SITProjects/INF2004/testing/terrain/TEST_LOG.md

# Terrain — test log

**Subsystem:** terrain  ·  **Student ID:** <student ID>  ·  **Code:** `app_program/terrain/`

See `testing/README.md` for how to run tests and record results.

## Test cases

Define a test here before running it. Test IDs never change.

| ID | What is tested | Requirement / interface | Method | Steps / how | Expected result |
|---|---|---|---|---|---|
| TER-U01 | IMU set up over I2C0 and delivering samples at about 100 Hz | | auto | `terrain_test.c`, GY-511 on Grove 3 | `[TEST] TER-U01 PASS` |
| TER-U02 | calibration becomes VALID within 5 s of power-up | | auto | `terrain_test.c`; car still on level ground during power-up | `[TEST] TER-U02 PASS` |
| TER-U03 | tilted car is refused | | manual | 1. Flash normal image with the car on a slope. 2. Watch the console. | `terrain: calibration NOT_LEVEL` |
| TER-U04 | pitch and roll read about 0 at rest after calibration | | auto | `terrain_test.c`; car still on level ground during power-up | `[TEST] TER-U04 PASS` |
| TER-U05 | pitch and roll match known angles | | manual | 1. Set `TERRAIN_DEBUG_PRINT_MS` to 500 locally (never commit it), build and flash. 2. Let it calibrate on level ground. 3. Tilt nose up to 10°, 20° and 30°, then nose down, checking each angle with a phone level app. 4. Repeat with the right side up, then the left side up. 5. Note the printed `pitch` and `roll` at each angle. | Within ±2° of the phone at each angle; nose up and right side up are positive |
| TER-U06 | record the level reference (after every remount) | | auto (bench) | 1. Set `TERRAIN_TEST_BENCH` to 1 locally (never commit it), build `make TEST=1` and flash. 2. Put the car on a floor checked to be flat. 3. Keep it still when the countdown ends. 4. Paste the printed `#define TERRAIN_LEVEL_REF_*` lines into `terrain_config.h` and rebuild. | `[TEST] TER-U06 PASS` and three `#define` lines |
| TER-U07 | each car axis points the right way after mounting | | auto (bench) | Same build as TER-U06; runs straight after it. Follow the console: 1. car flat; 2. nose lifted about 30°; 3. right side lifted about 30°. Hold still after each countdown until the reading prints. | Three `[TEST] TER-U07 PASS` lines; a FAIL names the `TERRAIN_CAR_*_FROM/SIGN` setting to check |
| TER-U08 | movement during calibration is retried | | manual | 1. Flash the normal image. 2. Shake the car gently for the first 3 s after power-up, then put it down flat and still. | `terrain: calibration VALID` about 2.5 s after the car is still |
| TER-U11 | IMU fault raised when the sensor stops and cleared when it is back | | manual | 1. Flash the normal image with the IMU connected; wait for `terrain: calibration VALID`. 2. Unplug the IMU cable from Grove 3. 3. Plug it back in. | After step 2: `terrain: IMU fault raised` within about 0.1 s (10 failed reads); after step 3: `terrain: IMU fault cleared`. Calibration stays VALID |
| TER-U12 | hump state machine and event queue give the right events | | auto | `terrain_test.c`; made-up roll data, so it needs only the Pico (the IMU may be missing). A 4-sample lean spike, then one ramp: climb and stay, come part way down, flat; then 17 events into the 16-event queue | Two `[TEST] TER-U12 PASS` lines: ASCENDING (carrying the lean), DESCENDING, LEVEL and nothing else; the oldest event dropped and counted |
| TER-U13 | no hump and no events at rest | | auto | `terrain_test.c`, runs after TER-U04; car still on level ground during power-up | `[TEST] TER-U13 PASS` (hump state LEVEL, the queue gives NONE) |
| TER-U14 | hump state follows the lean (one wheel lifted) | | manual | 1. Set `TERRAIN_DEBUG_PRINT_MS` to 500 locally (never commit it), build and flash. 2. Let it calibrate flat. 3. Lift one side of the car (or tilt the board sideways) about 6° and hold 1 s. 4. Lower it about 3° and hold 1 s. 5. Put it flat and still for 1 s. 6. Repeat with the other side | The printed `hump` reads ASCENDING then TOP during step 3, DESCENDING after 4 and LEVEL after 5, the same for either side. Tilting the nose up or down alone changes nothing |
| TER-U15 | hump height from made-up one-wheel ramps | | auto | `terrain_test.c`; one wheel driven at 120 mm/s over made-up ramps (each side three times as long as the ramp is high, 20 mm flat top) through the real hump machine (0.15 s tilt) and height code (its own 0.05 s smoothing), roll from the lift across the 110.6 mm track, so it needs only the Pico (the IMU may be missing). Ramps 6, 11 and 20 mm high | `[TEST] TER-U15 PASS` (each within ± 2 mm) |
| TER-U16 | hump height from a real lift of one wheel | | manual | 1. Build and flash (`make TEST=1` or `make`; the `terrain: hump` lines print without the debug switch). 2. Car on a flat floor; let it calibrate (`calibration VALID`). 3. Lift one drive wheel onto a block of known height (11 mm) for 1 s, then back down and still for 1 s. 4. Repeat with the other wheel. 5. Repeat with a 5–6 mm and a 15–20 mm block if available | Each lift prints `hump ASCENDING`, `hump DESCENDING`, `hump LEVEL height N mm` with N = block height ± 2 mm (a 5–6 mm block may only just be found) |
| TER-U17 | no false humps on a flat line run | | manual | 1. Flash the normal image (`make`); car still and level at power-up, then on a flat line track with no ramp. 2. Let it follow the line for at least one lap, including starts, stops and curves | `terrain: calibration VALID` before line following starts; no `terrain: hump` lines and no `events dropped` line. Any hump line is a false event: note where (start, stop, curve) |
| TER-U18 | one-wheel ramps on the line | | manual | 1. Flash the normal image (`make`); car still and level at power-up. 2. Put a ramp of known height under the path of one wheel on the line track: 11 mm (course), plus 5–6 mm and 15–20 mm if available. 3. Three runs each, then the same with the ramp under the other wheel | Each run prints ASCENDING, DESCENDING, LEVEL once, with the LEVEL height = ramp height ± 2 mm |
| TER-U19 | collision state machine on made-up pushes and speeds | | auto | `terrain_test.c`; made-up traces through the real collision code with the `terrain_config.h` limits, so it needs only the Pico (the IMU may be missing). Traces: a 0.8 g push; a 1.5 g push while the speed stays 120 mm/s (a jolt); pushes on a ramp (ASCENDING, DESCENDING) and a check cut short by ASCENDING; a 1.5 g then 1.8 g push with the speed dropping to 40 mm/s; a 2.5 g push with no stop; a 1.5 g push with the speed unknown; three 2.5 g pushes, the second inside the 500 ms cooldown | `[TEST] TER-U19 PASS` three times: no events for the first three traces; one COLLISION carrying 1.8 g; one carrying 2.5 g and one carrying 1.5 g; two events for the three pushes |
| TER-U20 | collision from a real push on the bench | | manual | 1. Build and flash the normal image (`make`). 2. IMU loose or car lifted off the floor, so motion's speed is 0 or unknown (the push alone decides). 3. Let it calibrate (`calibration VALID`), then keep it still. 4. Flick the board or car sharply sideways, then nose-first (a short hard tap, not a slow tilt). 5. Press it straight down hard. 6. Tilt it slowly to about 30 degrees and back | Steps 4: one `terrain: COLLISION push N g` line per flick, N at least 1.0. Steps 5 and 6: no COLLISION line (vertical push, slow tilt). Note the N values |
| TER-U21 | collisions and ramps on the car | | manual | 1. Flash the normal image (`make`); car still and level at power-up. 2. Drive at line-following speed into a soft wall (box, foam) 5 times, square on, then 5 times at an angle. 3. Drive over the 11 mm ramp under one wheel 5 times. 4. Line-follow one lap with starts, stops and curves. 5. To tune: set `TERRAIN_COLLISION_LIMIT_DG` to its lowest, 5 (0.5 g), locally so most bumps print, and repeat 2 and 3; never commit the lowered value | Step 2: one COLLISION line per hit. Steps 3 and 4: no COLLISION line. Step 5: note the smallest wall-hit push and the largest ramp or driving push; the limit goes between them, the sure value above every ramp push |
| TER-U22 | turn rate and turning state machine on made-up wheel speeds and turn rates | IF-05 | auto | `terrain_test.c`; made-up data through the real turn-rate maths and turning machine with the `terrain_config.h` limits, so it needs only the Pico (the IMU and motors may be missing). Wheel speeds: right 160 / left 80 mm/s, a turn in place at ±87 mm/s either way, equal speeds, a track width of 0. Turn-rate trace: still; 90 °/s one sample too short; 15 °/s (below the on limit); 90 °/s; 15 °/s (between the limits); still; a −25 °/s right curve; 5 °/s. Then the turn fields next to made-up hump fields | `[TEST] TER-U22 PASS` three times: 41.4, +90.1, −90.1, 0 and 0 °/s (± 0.5); TURNING, STRAIGHT, TURNING, STRAIGHT and nothing else; hump fields untouched by the turn step and cleared without touching the turning state |
| TER-U23 | turning on the car | IF-05 | manual | 1. Set `TERRAIN_DEBUG_PRINT_MS` to 500 locally (never commit it), build `make` and flash; car still and level at power-up. 2. Car still: note `turn`. 3. Turn in place 90° left, then 90° right (motion turn command). 4. Line-follow one lap with straights and curves. 5. Run one obstacle detour. 6. Stop tMotion (or unplug the motors' battery so odometry stops) and wait 2 s | Step 2: `turn 0 deg/s STRAIGHT`, no TURNING line. Step 3: one `terrain: TURNING` then one `terrain: STRAIGHT` line per turn; `turn` about +90 (left) and −90 (right) ± 5 while turning. Step 4: no TURNING lines on straights (small steering corrections ignored); note which curves give TURNING. Step 5: one TURNING/STRAIGHT pair per turn of the detour. Step 6: `turn 0 deg/s`, then STRAIGHT. Note any line on a straight: it means `TERRAIN_TURN_ON_DPS` is too low |
| TER-U24 | speed state machine on made-up wheel speeds | IF-05 | auto | `terrain_test.c`; made-up wheel speeds through the real speed machine with the `terrain_config.h` limits, so it needs only the Pico (the IMU and motors may be missing). Trace in whole 100 ms checks: stopped; one check at 100 mm/s; stopped; 40, 60, 80, 100 mm/s; 120 mm/s for 5 checks; one check at 140; 120 for 4 checks; 100, 80, 60, 40; stopped for 4 checks | `[TEST] TER-U24 PASS`: ACCELERATING, CRUISING, DECELERATING, STATIONARY and nothing else (the blip and the noisy check give nothing); ends STATIONARY |
| TER-U25 | speed state on the car | IF-05 | manual | 1. Set `TERRAIN_DEBUG_PRINT_MS` to 500 locally (never commit it), build `make` and flash; car still and level at power-up. 2. Car still: note `speed`. 3. Start line following from a standstill; run a straight, then stop it. 4. Turn in place 90° (motion turn command). 5. Stop tMotion (or unplug the motors' battery so odometry stops) and wait 2 s | Step 2: `speed STATIONARY`, no speed line. Step 3: `terrain: speed ACCELERATING`, then `CRUISING` within about 0.5 s; on the straight no more speed lines; on stopping `DECELERATING` then `STATIONARY`. Step 4: the same four lines (wheels speed up, steady, slow down, stop). Step 5: `STATIONARY` within about 0.3 s. Lines while cruising mean `TERRAIN_SPEED_CHANGE_MM_S` is too low; a missed ACCELERATING means it is too high |
| TER-U26 | run summary on made-up events | | auto | `terrain_test.c`; made-up events straight into the summary, so it needs only the Pico (the IMU and motors may be missing). 1. A short run with every kind of event: humps of 11, 9 and 20 mm, one COLLISION, two TURNING. 2. Humps of 10 to 80 mm, a 9th of 300 mm, 7 more of 5 mm, then 130 COLLISION and 130 TURNING. 3. Reset a used summary; NULL arguments | `[TEST] TER-U26 PASS` three times. Step 1: humps 3, heights 11 9 20, highest 20, collisions 1, turns 2, other kinds ignored; message `43 11 02 0B 09 14 00 00 00 00 00`. Step 2: after the 9th, count 9 and highest 255 with no 9th slot; at the end counts 15, 15, 127 and highest still 255; message `FF FF 7F 0A 14 1E 28 32 3C 46 50`. Step 3: all-zero message after the reset; NULL refused, nothing written |
| TER-U27 | run summary on the car | | manual | 1. Flash the normal image (`make`); car still and level at power-up. 2. Drive over the 11 mm ramp under one wheel 3 times. 3. Turn in place 90° twice (motion turn command). 4. Drive into a soft wall (box, foam) once. 5. Save the console output | A `terrain: summary` line right after every `hump LEVEL`, `TURNING` and `COLLISION` line, and at no other time. On the last one: humps 3 with the three LEVEL heights in order, highest the largest of them, collisions 1, turns at least 2 (curves may add more). Its `msg` bytes decode back to the same numbers: bytes 0-2 low byte first, hump count bits 0-3, highest 4-11, collisions 12-15, turns 16-22; bytes 3-10 the heights |
| TER-U28 | compass hard-iron offset (calibration spin) | | manual | 1. Flash `make MQTT=1 IR_CALIBRATION=1` (motors stay off) and log the MQTT console. 2. Put the car flat on the floor it will run on, away from laptops and steel. 3. Once `terrain: compass x …` lines appear (4 a second), turn the car slowly counter-clockwise by hand, two full turns in about 20 s, keeping it flat. 4. Set `TERRAIN_MAG_OFFSET_X` and `_Y` in `terrain_config.h` to the last `centre` values | `heading` rises while the car turns left and passes 0–3599 once per turn; the X and Y `span`s are within 20 % of each other and stop growing after the first turn; no `no reading` lines |
| TER-U29 | compass set up and reading | | auto | `terrain_test.c` | `terrain: compass ready` at start-up; at least 25 readings in 500 ms |
| TER-U30 | compass heading, range and fault handling on a stubbed magnetometer | | auto (host) | `sh testing/terrain/host/run.sh` in the dev container | `0 failure(s)` (CMP01..CMP05 PASS): heading counter-clockwise from north in 0–3599, X/Y range, an overflowed axis or failed read is no reading, set-up retried after 1 s |
| TER-U31 | compass against the wheel heading on the car | IF-05 | manual | After TER-U28: flash `make MQTT=1`, follow a line with a straight and a curve, save the `LT … c=… m=…` lines | while following, `c` changes by the same amount as `h` (within 10°) over the straight and the curve; on a straight `c` stays within 5° (the motor currents do not swing it) |
| TER-U33 | the course's hump through the real hump and height code | `terrain_detect.c`, `terrain_height.c` | auto (host) | `sh testing/terrain/host/run.sh` | TH01..TH14 PASS |
| TER-U34 | lifted and overturned stop the motors | IF-11, `terrain_detect.c`, `obstacle.c` | auto (host and on-target) + manual (car) | Host: `sh testing/terrain/host/run.sh` (LF01 to LF11, on cuts of the 2026-11-11 captures in `lift_fixture.h`). On target: `make TEST=1`. Car: flash `make MQTT=1`; drive a full lap, hump and junctions included, untouched; then lift the moving car briskly three times and the stopped car twice, putting it down and pressing Start each time; then turn it on its side and upside down | Host: 43 s of floor driving gives nothing; all eight demo-style lifts and both overturns are found; a slow, gentle lift is not (the known limit); margins either side of 1.30. Car: no stop during the lap; each lift gives `terrain: LIFTED` and `obstacle: car lifted`, the motors stop within about 0.3 s and the dashboard shows the car stopped; Start runs it again; each overturn gives `terrain: OVERTURNED` |

*Method:* **auto** = `TEST_CHECK` in code, result printed on the console;
**auto (bench)** = `TEST_CHECK` in code that needs a person to move the car on
cue, built only with `TERRAIN_TEST_BENCH` set to 1;
**auto (host)** = a host program runs the production module with stubbed
hardware, no Pico needed;
**manual** = a person observes the result (LED, scope, meter, phone app…).

## Results

Add a new row for every run. Never edit or delete old rows.

| Date | Test ID | Commit | Tester | Result | Log / evidence | Notes |
|---|---|---|---|---|---|---|
| YYYY-MM-DD | TER-U01 | `abc1234` | | PASS / FAIL | `logs/YYYY-MM-DD_….txt` | |
| 2026-11-02 | TER-U06 | `4a4be96` | ann | PASS | `logs/2026-11-02_ter_u06_level_ref.txt` | Loose IMU taped flat on a levelled desk; new reference X -0.470, Y 0.743, Z 8.491 m/s^2. TER-U07 not done (IMU stayed taped) |
| 2026-11-02 | TER-U01 | `4a4be96` + new reference | ann | PASS | `logs/2026-11-02_ter_u01_u02_u04.txt` | Packed code, loose IMU |
| 2026-11-02 | TER-U02 | `4a4be96` + new reference | ann | PASS | `logs/2026-11-02_ter_u01_u02_u04.txt` | VALID about 2.6 s after boot |
| 2026-11-02 | TER-U04 | `4a4be96` + new reference | ann | PASS | `logs/2026-11-02_ter_u01_u02_u04.txt` | Pitch and roll within 1 degree |
| 2026-11-02 | TER-U11 | `4a4be96` + new reference | ann | PASS | `logs/2026-11-02_ter_u11_imu_fault.txt` | Raised on unplug, cleared on replug, calibration stayed VALID. Sampling after the reconnect not checked |
| 2026-11-03 | TER-U12 | `d8f21d3` + P4 (uncommitted) | ann | PASS | `logs/2026-11-03_ter_p4_hump_events.txt` | Both checks: hump trace events and drop-oldest queue |
| 2026-11-03 | TER-U13 | `d8f21d3` + P4 (uncommitted) | ann | PASS | `logs/2026-11-03_ter_p4_hump_events.txt` | Loose IMU taped flat; hump LEVEL, queue empty |
| 2026-11-03 | TER-U02 | `d8f21d3` + P4 (uncommitted) | ann | PASS | `logs/2026-11-03_ter_p4_hump_events.txt` | VALID about 2.8 s after boot |
| 2026-11-03 | TER-U04 | `d8f21d3` + P4 (uncommitted) | ann | PASS | `logs/2026-11-03_ter_p4_hump_events.txt` | |
| 2026-11-03 | TER-U01 | `d8f21d3` + P4 (uncommitted) | ann | FAIL | `logs/2026-11-03_ter_p4_hump_events.txt` | Test-order artefact: other subsystems' tests skipped locally, so it ran before the IMU was set up. Not a P4 fault |
| 2026-11-03 | TER-U14 | `d8f21d3` + P4 (uncommitted) | ann | PASS | `logs/2026-11-03_ter_u14_hump_states.txt` | Loose IMU tilted by hand to about +45 deg and -30 deg: LEVEL, ASCENDING, TOP, DESCENDING, LEVEL. Wobbles under 4 deg ignored |
| 2026-11-03 | TER-U15 | `5973939` + P9 (uncommitted) | ann | PASS | `logs/2026-11-03_ter_p9_hump_height.txt` | First run, old reference: TER-U01, U12 x2, U15 PASS; TER-U02, U04, U13 FAIL (`calibration NOT_LEVEL`: IMU placed more than 2 deg from the 2026-11-02 reference). No log kept |
| 2026-11-03 | TER-U06 | `5973939` + P9 (uncommitted) | ann | PASS | values copied from the console (no log kept) | New bench reference X -0.366, Y 0.922, Z 8.522 m/s^2 (1.4 deg from 2026-11-02). Loose IMU taped flat, chip up. TER-U07 not done: the countdown could not be followed among other subsystems' console output |
| 2026-11-03 | TER-U01 | `5973939` + P9 (uncommitted) | ann | FAIL | no log kept | Run after TER-U06: TER-U12 x2 and U15 PASS; U01, U02, U04, U13 FAIL, no `terrain:` lines seen (likely the Grove cable, reseated before the next run, or the console opened late) |
| 2026-11-03 | TER-U01 | `5973939` + P9 (uncommitted) | ann | PASS | `logs/2026-11-03_ter_p9_hump_height.txt` | Cable reseated; new reference. Other subsystems' tests skipped locally in `app_main.c` (restored after) |
| 2026-11-03 | TER-U02 | `5973939` + P9 (uncommitted) | ann | PASS | `logs/2026-11-03_ter_p9_hump_height.txt` | |
| 2026-11-03 | TER-U04 | `5973939` + P9 (uncommitted) | ann | PASS | `logs/2026-11-03_ter_p9_hump_height.txt` | |
| 2026-11-03 | TER-U12 | `5973939` + P9 (uncommitted) | ann | PASS | `logs/2026-11-03_ter_p9_hump_height.txt` | Both checks: P4 unchanged by P9 |
| 2026-11-03 | TER-U15 | `5973939` + P9 (uncommitted) | ann | PASS | `logs/2026-11-03_ter_p9_hump_height.txt` | 40 mm narrow and 80 mm long-ramp made-up humps |
| 2026-11-03 | TER-U13 | `5973939` + P9 (uncommitted) | ann | PASS | `logs/2026-11-03_ter_p9_hump_height.txt` | |
| 2026-11-03 | TER-U16 | `5973939` + P9 (uncommitted) | ann | NOT RUN | — | Deferred to car day (bench set-up too fiddly; the debug print needed for it can freeze the console, Q3). Tilt estimate covered by TER-U15 and host tests |
| 2026-11-06 | TER-U28 | #136 | Kitsunez | PASS | `logs/2026-11-06_TER-U28_mqtt.txt` (not committed) | Two turns counter-clockwise by hand: heading rose through 0–3599 twice; spans X 956, Y 904 (6 % apart); centre X -347, Y -96, set as `TERRAIN_MAG_OFFSET_*`. Prints came every 0.6 s instead of 0.25 s: the terrain loop runs slow |
| 2026-11-06 | TER-U31 | #136 | Kitsunez | FAIL | `../system/logs/2026-11-06_car7_mqtt.txt` (not committed) | Line run, offsets applied offline. Field strength 210–315 counts while driving against 465 in the spin; `c` rose 25° over 150 mm of straight with `h` 0 and no sensor events; in turns `c` and `h` agree within about 15°. The motors (or the floor) disturb the compass: not usable for steering |
| 2026-11-07 | TER-U02 | level check widened for the mounted IMU | Kitsunez (host) | NOT RUN | `python3 testing/communication/host/dashboard_test.py` D26 | Not run on the car. All 53 calibrations logged on the car ended NOT_LEVEL against the 2026-11-03 bench reference, so tilt and humps never ran and CAR read 0. TERRAIN_LEVEL_MAX_DEG 2 to 30 for now; the `terrain: calibration` line now gives the tilt and reading to record as the new reference. Results land near 10.5 s: 0.5 s settling and five 2 s attempts, so samples arrive at 100 Hz and earlier attempts count as moved. |
| 2026-11-07 | TER-U02 | mounted level reference | Kitsunez (car and host) | PASS | `testing/system/logs/2026-11-06_dash5_mqtt.txt` boots 38 to 40 | Calibration VALID at 3.1 to 5.6 s with the 30 degree limit, 12.3 to 13.0 degrees from the old reference. New reference is the mean of the three; limit 5 degrees. First car run also counted 15 false humps, up to 48 mm: 15 of 17 starts were off the line. Humps now looked for only while following at 20 mm/s or more. One start at 2.7 degrees on a cross tape stays; no real hump run yet to set the threshold against. |
| 2026-11-07 | TER-U33 | real hump at 120 mm/s | Kitsunez (car and host) | PASS (host) | `testing/system/logs/2026-11-06_dash5_mqtt.txt` boot 42 | First real hump, inferred from roll: +2 to +4.4 degrees for about 2.3 s over d 1880 to 2160, counted, read 16 mm against 10. The car wobbled up to 15 degrees across it and stayed on the line. Five other detections lasted 0.2 to 0.6 s, in bends or just after the bypass. TERRAIN_HUMP_MIN_MS 800, so they no longer count; height smoothing 0.05 to 0.15 s, 9 to 10 mm in the model. The new height is not yet checked on the car. |
| 2026-11-07 | TER-U33 | humps by travel, collisions only driving | Kitsunez (car and host) | PASS (host) | `testing/system/logs/2026-11-06_dash5_mqtt.txt` boot 43 | One real hump, as the user confirmed: 188 mm from climb to level, 1.7 s, read 13 mm. Three false ones still counted over 0.8 s, at 34, 67 and 122 mm, so the rule is now 130 mm of travel. All 5 collisions false: 3 from starts, reversing or a slow pass restarting, one a hand on the stopped car, one at a 24 degree lean. Pushes now count only driving forward at 60 mm/s or more and leaning under 8 degrees. A real collision has not been tried. |
| 2026-11-07 | TER-U33 | hump survives braking for it | Kitsunez (car and host) | FAIL (car), PASS (host) | `testing/system/logs/2026-11-06_dash5_mqtt.txt` boot 48 | The user drove over the hump after `F` and none counted: `hu=0` all run. The slow-down braked the car under the 20 mm/s hump speed, which dropped the hump, so it sped up, leaned, braked again: 2 to 4 slow-downs a pass, most about 10 mm. Too slow now only pauses, and a car that slowed needs 90 mm of travel, not 130. In the closed-loop model the hump takes 119 mm and counts once, a steering lean 18 mm. Not yet run on the car. |
| 2026-11-09 | TER-U33 | slowed hump passes shorter than the minimum | Kitsunez (car and host) | FAIL (car, last image), PASS (host) | `testing/system/logs/2026-11-06_dash5_mqtt.txt` boots at 09:48 and 09:48:47, image 11:02:47 (not committed), `sh testing/terrain/host/run.sh` | Humps stayed 0. Five passes with the hump's roll of 5 to 7 degrees took 66 to 89 mm, under `TERRAIN_HUMP_SLOW_MIN_MM` 90. 15 logged slowed passes took 66 to 116 mm and leans with no hump 55 mm or under, so it is now 60; TH15 added. The three boots before those ended NOT_LEVEL (5.9 to 6.9 degrees), which turns humps off. Not run on the car. |
| 2026-11-09 | TER-U33 | level reference re-recorded | Kitsunez (car and host) | FAIL (car, last image), PASS (host) | `testing/system/logs/2026-11-06_dash5_mqtt.txt` boots from 09:39 to 10:51 (not committed), `sh testing/terrain/host/run.sh` | Seven of nine boots read NOT_LEVEL (5.1 to 9.4 degrees), and two passed at 4.3 and 4.9. The car rests about 5 degrees further front to back than when the reference was taken on 2026-11-07. New reference: the mean of eight of those boots, leaving out the 9.4. The nine boots then read 0.4 to 4.1 degrees. Whether that floor is flat was not checked. Not run on the car. |
| 2026-11-09 | TER-U33 (on the car) | slowed hump counted | Kitsunez | PASS | `testing/system/logs/2026-11-06_dash5_mqtt.txt` 11:23 boot, image 03:18:54 (not committed) | Three passes counted: 11, 7 and 9 mm, over 59, 89 and 110 mm of travel. No false hump from the other leans on those runs. |
| 2026-11-09 | TER-U21 | a hit counted from the wheels stopping dead | Kitsunez (car and host) | FAIL (car, last image), PASS (host) | `testing/system/logs/2026-11-06_dash5_mqtt.txt` 11:23 boot, image 03:18:54 (not committed), `sh testing/terrain/host/run.sh` | Three hits on a box from 120 mm/s, at d=180 to 194: the jolt read under 0.3, under 0.3 and 0.66 g, against 0.55 g just driving, 0.62 g braking and 0.95 g on the hump, so no push limit separates them. The speed fell to under 10 mm/s in under 0.5 s each time. TH16 to TH24 added, 11 mutations caught. In the logs, 4 such falls with no reason logged in about 5 hours of following. Not run on the car. |
| 2026-11-09 | TER-U21 (on the car) | a hit counted from the wheels stopping dead | Kitsunez | PASS (2 of 3) | `testing/system/logs/2026-11-06_dash5_mqtt.txt` 11:33 boot, image 03:30:15 (sonar limits 3/1/2 mm, not committed) | Two box hits counted, each once. The third was stopped by the ultrasonic's CRITICAL as the car touched the box, so it left following before the speed fell; the normal image stops well before that. No false count in those runs, but the log has no hump pass or long drive with this rule. |
| 2026-11-11 | TER-U34 (capture) | 100 Hz accelerometer with `TERRAIN_CAPTURE` 1, #148 | Kitsunez | INFO | `logs/2026-11-11_lift_capture_mqtt.txt`, `logs/2026-11-11_lift_capture2_mqtt.txt` (not committed) | The 100 ms mean's upward part, against the calibration's level reading: 43 s of floor driving with speed changes and bumps at most 1.17, never tilted over 20 degrees for more than 60 ms; eight demo-style lifts (five moving, three stopped) 1.42 to 1.63; a slow, gentle lift 1.09 and 22 degrees, the same as driving. On its side 73 to 110 degrees, upside down 147 to 179. The limits, 1.30 and 60 degrees for 300 ms, sit between. Collision detection is removed (TER-U19, TER-U21 retired). |
| 2026-11-11 | TER-U34 | #148 | Kitsunez (host) | PASS (host) | `sh testing/terrain/host/run.sh` | LF01 to LF11 pass; the full captures replayed through the firmware's code find every lift and overturn and nothing in the floor driving. 12 planted bugs each fail at least one check. On-target TER-U34 built (`make TEST=1`), not run. Not run on the car; the track's hump and junctions are not recorded at 100 Hz yet. |
