SITProjects/INF2004/testing/obstacle/TEST_LOG.md

# Obstacle — test log

**Subsystem:** obstacle  ·  **Student ID:** <student ID>  ·  **Code:** `app_program/obstacle/`

See `testing/README.md` for how to run tests and record results.

## Test cases

Define a test here before running it. Test IDs never change.

| ID | What is tested | Requirement / interface | Method | Steps / how | Expected result |
|---|---|---|---|---|---|
| OBS-U01 | scan task started (obstacle module initialised) and sleeps between scans | | auto | `obstacle_test.c` | `[TEST] OBS-U01 PASS` |
| OBS-U02 | servo PWM slice runs at 50 Hz (1 MHz counter, wrap 19999) | | auto | `obstacle_test.c` | `[TEST] OBS-U02 PASS` |
| OBS-U03 | clear path ahead reports CLEAR | | manual | 1. Flash normal image. 2. Keep at least 40 cm in front of the sensor clear (30 cm candidate threshold). 3. Watch the console. | `obstacle: [0x11] CLEAR dir 90` |
| OBS-U04 | obstacle inside the configured detection threshold starts a side scan | | manual | 1. Place a flat board at 150 mm (inside the configured detection distance and above critical release). 2. Watch the servo and console through both side positions and return to centre. | servo turns to 50° then 130°, then steps inward 10° from each end that missed the board; console reports `PATH_FOUND` or `BLOCKED`, with a width when measured, once after the sweep |
| OBS-U10 | packed obstacle fields at boundaries and invalid values | robot_types.h | auto | `obstacle_test.c`: valid flags, min/max/one-beyond/invalid fields, edge sentinels, width saturation and sequence wrap | `[TEST] OBS-U10 PASS`; neighbouring fields unchanged |

Additional regression cases:

| ID | What is tested | Requirement / interface | Method | Steps / how | Expected result |
|---|---|---|---|---|---|
| OBS-U12 | no-return and beyond-range policy | driver → scanner | manual | Scope TRIG/ECHO in open space; include a pulse lasting about 38 ms, if produced by this module. Record trigger-to-rise, pulse duration, driver outcome and scanner status. | NO_ECHO then CLEAR; late falling edge does not overwrite a result; next trigger waits for configured interval |
| OBS-U13 | malformed or stuck-high echo | driver → scanner | manual | Check ECHO high before trigger, duplicate/ambiguous edges and a zero pulse using controlled input. | FAULT; never classed as a no-return clear reading |
| OBS-U14 | side selection and fault policy | scanner | manual | With motors unable to move, keep the centre obstacle inside detection. Arrange one finite side return beyond both the configured detection threshold and the centre echo + `OBSTACLE_EDGE_JUMP_US` (about 80 mm additional ray range); repeat with the sides mirrored, both sides occupied, NO_ECHO and a faulty side. Record centre/side echoes and final direction. | Only a side meeting both limits, or NO_ECHO, is chosen; farther clear wins and ties choose left. No clear side gives BLOCKED, or UNKNOWN if a side faulted |
| OBS-U15 | active pin allocation | config → hardware | manual | Scope GP16 TRIG width and nominal forward trigger cadence in a stable clear-path centre scan (allow polling jitter; side scans have different cadence); scope GP12 servo period/centre width. Confirm GP17 input changes with sensor distance. Inspect GPIO function/output-enable registers or debugger pinmux state and obstacle source to establish ownership of GP2/GP3; quiet pins alone do not establish pin allocation. | TRIG GP16, ECHO GP17, servo GP12; one configured scan priority |
| OBS-U16 | ping median | `obstacle_decision.c` | auto | `obstacle_test.c`: zeros ignored (not majority voting: `{0, 0, 300}` gives 300 us), two nonzero samples averaged without overflow, all-zero gives 0, NULL/zero count gives 0, only the first 3 samples used | `[TEST] OBS-U16 PASS` |
| OBS-U17 | position result after its pings | `obstacle_decision.c` | auto | `obstacle_test.c`: exhausted retries give FAULT regardless of median; zero median gives NO_ECHO; otherwise VALID | `[TEST] OBS-U17 PASS` |
| OBS-U18 | centre decision at the detection threshold | `obstacle_decision.c` | auto | `obstacle_test.c`: NO_ECHO, echo at and above `OBSTACLE_DETECT_ECHO_US` → CLEAR; one below and 1 µs → scan sides; FAULT/PENDING → UNKNOWN | `[TEST] OBS-U18 PASS` |
| OBS-U19 | side selection | `obstacle_decision.c` | auto | `obstacle_test.c`: 22 cases covering both near, detection and flat-face (centre / cos 40° + jump at the 40°-off ends) boundaries, a square-on wall reading the centre echo / cos 40° at the ends, ties, farther side, no-echo ranking, faults, and 32-bit addition near UINT16_MAX | `[TEST] OBS-U19 PASS`; on failure the console names the failing case number |
| OBS-U52 | side/width classification agreement | `obstacle_decision.c`, `obstacle_width.c` | auto | Grid of centre/side echoes at detection and end flat-face boundaries, zero and UINT16_MAX; test both directions with the opposite side faulted | A VALID side is chosen exactly when it is a width MISS and meets detection; otherwise UNKNOWN with no direction; sums do not wrap |
| OBS-U54 | wide wall must not offer a bypass | scanner, #88 | manual | Motors unable to move; after ranging/servo calibration, place a flat board square-on at 250 mm, then 290 mm from the sensor face, spanning the entire 50–130 degree sweep. Capture five complete sweeps at each position, recording measured echoes and final results | Every completed valid sweep is BLOCKED, never PATH_FOUND; sensor faults are recorded separately and are not PASS |

Width sweep cases (#48). Synthetic geometry uses a fixed fixture (scale 1715,
no offsets, correction 0 unless stated), so production calibration cannot
change the expected values.

| ID | What is tested | Requirement / interface | Method | Steps / how | Expected result |
|---|---|---|---|---|---|
| OBS-U05 | sweep classification | `obstacle_width.c` | auto | Centre 1458 us: at the centre VALID 1923, 1924 and 1, NO_ECHO, FAULT, PENDING; 30° off (indices 1/7) VALID 2149 and 2150; 40° off (indices 0/8) VALID 2368 and 2369; beyond the grid VALID 1924; centre 65500 with VALID 65535 at the centre and an end | HIT, MISS, HIT, MISS, INVALID, INVALID; HIT, MISS; HIT, MISS; MISS (treated as centre); HIT, HIT (no wrap) |
| OBS-U06 | wall wider than the sweep | `obstacle_width.c` | auto | Wall 100 mm ahead: hits at indices 0 and 8 (50°/130°), 761 us each | 168 ±2 mm; both edges not found; edges 0/8 |
| OBS-U07 | centred box | `obstacle_width.c` | auto | 200 mm box at 250 mm: hits at indices 2 and 6 (70°/110°), 1551 us | 225 ±2 mm; both found; boundaries 65.0° and 115.0° |
| OBS-U08 | shifted box | `obstacle_width.c` | auto | Same box 80 mm left: hits 1 (60°, 1683 us) and 4 (1458 us); a 230 mm box 150 mm ahead: hits 1 and 7 (60°/120°), 1010 us | 188 ±2 mm, both found; 199 ±2 mm, both found (the 60–120° sweep found neither edge); no edge correction |
| OBS-U09 | pole and collapsed edges | `obstacle_width.c` | auto | 20 mm pole at 250 mm: both hits at 6, 1458 us; then correction 6° | 44 ±2 mm (half steps of 5°), not collapsed; then 1 mm, collapsed, both boundaries 90.0° |
| OBS-U11 | saturation and rejected input | `obstacle_width.c` | auto | Ends at 3499 us; left index 7, right index 5, index 13, zero echo, NULL config, scale 0, correction NaN/infinite/−1/16, radial offset −500 mm and infinite | 511 mm; every rejected case unavailable (0 mm, EDGE_NONE, flags false) |
| OBS-U33 | width accuracy and edge correction | scanner → obstacle word | manual | After OBS-U28/U29/U30 and the pivot measurement, with the car unable to move: fit the edge correction on centred 200 mm boxes at 200 and 250 mm (c = 0 build, boundary angles from the log), then run the validation matrix in the #48 plan, 5 runs per case. Measure d from the servo axis | Eligible cases (\|x0\| + W/2 < 0.577 d, 10 mm margin): both edges found and every run within 10 %; a missed edge is a FAIL. Clipped cases: clipped side not found, width ≤ visible width ±10 mm. Two-box case recorded as a limitation |
| OBS-U34 | sweep time | scanner | manual | 200 mm box at 250 mm, 10 runs: `side scan started` to `side scan completed after N ms` | Every run below `OBSTACLE_SIDE_SCAN_WORST_MS`; mean and max recorded. Does not show the whole-bypass < 3 s target (integration) |

Bypass geometry, planner and state machine (issue #86):

| ID | What is tested | Requirement / interface | Method | Steps / how | Expected result |
|---|---|---|---|---|---|
| OBS-U35 | bypass plan, left gap | `obstacle_avoid.c` | auto | Fixture car (W/2 75, margin 60, axle–pivot 80, rear 60, depth 200); centre 250 mm, edges ±100 mm | Sidestep 235 mm, pass 650 mm, status OK |
| OBS-U36 | bypass plan, clearest side | `obstacle_avoid.c` | auto | Edges +40 and −120 mm with the scanner choosing right; then only the right edge found | Measured-clearer right taken at 255 mm despite a 175 mm left detour; a scanner-selected left without a left edge stays left at the 400 mm maximum |
| OBS-U37 | bypass plan limits, best effort | `obstacle_avoid.c` | auto | Needed sidestep 401 and 400 mm; below the minimum; only the right edge; width unavailable; pass 1500 and 1501 mm; split counts and parts | 401 capped to 400 with `b_limited`; 400 kept; raised to 100; scanner-selected left without an edge gives 400; unknown width gives 400 on the scanner's side; 1501 capped to 1500 with `b_limited`; splits 0/1/1/2/2/3 for 0/1/1023/1024/2046/2047 mm, parts 750 for 1500 and 683 for 2047 |
| OBS-U38 | bypass plan refusals | `obstacle_avoid.c` | auto | SCANNING, CLEAR, UNKNOWN; BLOCKED with the right edge found; BLOCKED with no edge; PATH_FOUND centre with no edge; centre 0; NULL car | NOT_PATH, except BLOCKED with a found edge plans round it (right, 235 mm); NO_GEOMETRY for centre 0 |
| OBS-U39 | edge lateral offsets | `obstacle_width.c` | auto | OBS-U07 box (edges 65° and 115° at 266 mm); unavailable result | `left_x_mm` 109..115, `right_x_mm` −115..−109; unavailable gives 0, 0 |
| OBS-U40 | range reference point | `obstacle_width.c` | auto | 1551 µs at the fixture scale with a 20 mm radial offset; echo 0, NULL config or output, range at or below zero | 286 ±0.5 mm from the pivot (offset added once); every invalid case false with the output untouched |
| OBS-U41 | corridor check | `obstacle_avoid.c` | auto | Fixture car, pass 650 mm: empty sweep; 250 mm ahead; 290 mm at 100° (left gap) and 80° (right gap); 800 mm ahead plus a 400 mm wall at 60°; that wall with 250 mm ahead; one invalid position | CLEAR; SHIFT 135; SHIFT 85 both mirrors; CLEAR; BLOCKED (65 mm room < 135 mm); BLOCKED |
| OBS-U42 | bypass: start-up hold and stop | `obstacle_avoid.c` (simulated tMotion) | auto | Start held; 20 loops with the stop latched; clear path; stop while following; tMotion that never reports INHIBITED | No INHIBIT clear until the first clear result, then FOLLOW and IDLE; INHIBIT set in the loop that sees the stop; WAIT_RESULT on INHIBITED; FAULT `STOP_ACK` after 500 ms, not before |
| OBS-U43 | bypass: release order and pending commands | `obstacle_avoid.c` (simulated) | auto | PATH_FOUND with tMotion still INHIBITED for 3 loops; sends return E_TMOUT; FOLLOW busy for over 200 ms; send error; failed INHIBIT call | No send until INHIBITED is left; the same turn resent until queued, exactly once; FOLLOW also resent, FAULT `KERNEL` past 200 ms; send error and INHIBIT failure latch FAULT at once |
| OBS-U44 | bypass: latched stop across turns | `obstacle_avoid.c` (simulated) | auto | Stop still latched from detection; rearm publishes sequence 255; CLEAR at 255, then CLEAR at 0; a fresh UNKNOWN in PREPARE | The turn runs with the stop latched; the sidestep waits in PREPARE through the stale CLEAR and is sent at sequence 0 (wrap); UNKNOWN holds in BLOCKED_WAIT |
| OBS-U45 | bypass: verify and repeated sidesteps | `obstacle_avoid.c` (simulated) | auto | Two corridors with a point 250 mm ahead, then a clear one; stale corridor sequence; sidesteps limited to 1 | Extra 135 mm sidesteps each time; offset 505 mm; return command 655 mm with stop-at-line; stale sweep ignored; over the limit: BLOCKED_WAIT, FAULT `BLOCKED` after 5 s |
| OBS-U46 | bypass: return leg completion | `obstacle_avoid.c` (simulated) | auto | 900 mm sidestep (1050 mm return in two parts), line seen on the first part; line missed twice on a normal return | First part 525 mm; DONE_LINE skips the remaining return, drives the 40 mm overshoot, then turns 90° left back to the stop heading (odometry −90 → 0) and sends FOLLOW; first miss holds 1 s then searches 150 mm with stop-at-line; second miss hands over to line following (FOLLOW, no FAULT) |
| OBS-U47 | bypass: faults and the one retry | `obstacle_avoid.c` (simulated) | auto | Stall at 100 of 235 mm; second stall; 1000 loops of clear paths and new PATH_FOUND results in FAULT; stall at 230 mm; ENC_FAULT; REJECTED; stall without odometry | Resumes 135 mm after the delay; then FAULT; FAULT keeps asking for INHIBIT and never clears it, sends or rearms; 5 mm remainder counts as done (turn back next, offset 235 mm); FAULT `ENCODER`, `REJECTED`, `ODOMETRY` |
| OBS-U48 | bypass: obstacles during the bypass | `obstacle_avoid.c` (simulated) | auto | Stop at 50 mm into the sidestep, cleared; a stop that never clears; stop and then CRITICAL during the first turn; a full box with ideal answers | Held, then resumes 185 mm after a fresh CLEAR; FAULT `BLOCKED` after 5 s; turn ignores the stop but holds on CRITICAL; full box ends with FOLLOW queued and IDLE |
| OBS-U55 | bypass: angled path | `obstacle_avoid.c` (simulated) | auto | Fixture car with a 30° minimum: plan angles at centre 250, 600 and 50 mm; then a full bypass at 600 mm | Angles 55°, 30° and 90° (and 90° with a 90° minimum); commands in order: turn 30° left, 470 mm, turn 30° right, 593 mm pass (1000 less the diagonal's 407), turn 15° right without and 15° right with stop-at-line, 770 mm with stop-at-line; when that return finds a line, 40 mm on, turn 30° left back to the stop heading, FOLLOW |
| OBS-U56 | bypass without re-checks | `obstacle_avoid.c` (simulated) | auto | Re-checks off; the stop request latched through a whole box; then CRITICAL 50 mm into the sidestep, cleared with the stop still latched | No rearm or corridor request; the latched stop never holds a move; full box ends with FOLLOW; CRITICAL holds, and clearing it resumes 185 mm without a rearm |
| OBS-U57 | bypass back-off | `obstacle_avoid.c` (simulated) | auto | Re-checks off, 50 mm back-off, 2 at most, 300 ms delay: CRITICAL 100 mm into the 235 mm sidestep, three times | Planning turns side scans off; each hold reverses 50 mm then drives the remainder plus 50 mm (185, then 235 mm); the third turns back to re-sweep; the box completes and FOLLOW turns side scans back on |
| OBS-U58 | bypass re-sweep | `obstacle_avoid.c` (simulated) | auto | CRITICAL held on the pass (left side, 235 mm out), then a corridor with a point 250 mm ahead; CRITICAL held 100 mm into the sidestep, then a clear corridor | Pass: corridor re-sweep, then a 135 mm extra sidestep on the left (offset 235 mm so far), INHIBIT released, turn 90° left. Sidestep: turn back keeping 100 mm offset, corridor re-sweep, then the 650 mm pass |
| OBS-U59 | bypass reverse for room | `obstacle_avoid.c` (simulated) | auto | 200 mm minimum room: plans at 50 mm and 250 mm; a bypass starting 50 mm away with CRITICAL set, then a corridor with a point ahead; again with a clear corridor | 50 mm: reverse 150 mm, pass 600 mm; 250 mm: no reverse. The bypass reverses 150 mm first (CRITICAL does not stop a reverse), sweeps the corridor, then turns 90° left for a 135 mm sidestep. With a clear corridor it resumes FOLLOW |
| OBS-U60 | bypass plan, free space first | `obstacle_avoid.c` | auto | Edges +300 (left needs 435) and −40 mm (right needs 175), scanner chose right: left end clear only; both clear; right clear only with no right edge | Left only: left, capped at 400 with `b_limited`. Both: right at 175. Right only: right at 400, edge unknown |
| OBS-U61 | bypass back-off in a turn | `obstacle_avoid.c` (simulated) | auto | Re-checks off, one 50 mm back-off, 300 ms delay: CRITICAL 40° into the 90° turn out | Holds; after 300 ms reverses 50 mm; then turns the remaining 50° |
| OBS-U62 | bypass: no side fits, reverse and look again | `obstacle_avoid.c` (simulated) | auto | Re-checks off, start 50 mm away (reverse for room), corridor blocked both ways three times; again with a clear corridor after the first; then a BLOCKED first sweep | Each blocked corridor reverses 100 mm and sweeps again (escape 100, 200, 300 mm), then waits held in BLOCKED_WAIT; clear after the first: FOLLOW; BLOCKED first sweep: reverses 100 mm before any turn, then sweeps. No 90° look |
| OBS-U63 | bypass: complete pass before route reacquisition | `obstacle_avoid.c` (simulated) | auto | Both gap directions: outward move and pass ignore line crossings; the first half of the turn in has no stop-at-line; inject LINE on the second half of the turn in and on the return; delay the overshoot enqueue; combine LINE with CRITICAL and outward obstruction | No early line handoff before completing the pass or before half the turn in; LINE queues the 40 mm overshoot (busy retries), then a home turn of 45° (after half the turn in) or 90° (after the return) toward the gap side, then FOLLOW at the stop heading; obstacle inhibition retains priority |
| OBS-U64 | measured-clearance preference reaches the planner | scanner decision → planner | auto | Both mirrors: farther clear echo on the side needing a 435 mm detour versus 175 mm on the other; remove the preferred edge; then NO_ECHO versus a finite return | Preferred farther side is retained, capped at 400 if necessary; unknown edge does not flip it; NO_ECHO ranks above finite clearance |
| OBS-U65 | replan chooses the clearest usable sector | corridor → planner | auto | Central obstacle needing equal shifts: side returns 6000/9000 us, mirrored, equal, and right NO_ECHO | Greater nearest sector clearance wins; ties retain the current side; NO_ECHO outranks finite returns; feasibility and lateral limits still apply |
| OBS-U66 | bypass plan, room past a clear end | `obstacle_avoid.c` | auto | Fixture car, centre 250 mm, edges ±60 mm (195 mm sidestep either way), scanner chose right, both ends clear; ends 40° off the heading; right end at 513, 514 and 849 mm; then both ends at 300 mm; then left at 350 mm | 513 mm (329.8 mm out, needs 330): left at 195; 514 mm: right; 849 mm (650.4 mm ahead, beyond the 650 mm pass): right; both at 300 mm: the scanner's right, flagged tight (no reverse); left at 350 mm: the roomier left, flagged tight |
| OBS-U67 | bypass: watch the obstacle side while driving | `obstacle_avoid.c` (simulated) | auto | Left gap, 235 mm sidestep, re-checks off; watch readings on the diagonal of 220 mm (110 mm from the path) then 200 mm (100 mm); on the pass 100 mm in, 200 mm; in the extra sidestep, 40 mm; on the pass again, 200 mm; then no echo after 0, 223 and 224 mm more | Servo set to 60° (right on the car). 110 mm is outside the 105 mm trigger (half the car plus half the margin): no change. 100 mm: diagonal lengthened to 270 mm (35 mm, restoring the 135 mm margin), sent as a 35 mm part. On the pass: held, 35 mm extra sidestep (70 mm in all). The 40 mm and later 200 mm readings would pass the 80 mm cap: refused, the pass continues for 550 mm at 305 mm out. No echo while the last point seen (174 mm ahead) is not passed by 50 mm keeps watching; at 224 mm: servo back ahead, watch done |
| OBS-U69 | bypass: back to the stop heading | `obstacle_avoid.c` (simulated) | auto | Stopped on heading 0; line found on the return with odometry at −97°, −2°, +350° and with odometry invalid | Home turn 97° left (not the planned 90°); −2° is under the 3° resume minimum: FOLLOW at once; +350°: 10° left, the shorter way; no odometry: FOLLOW without a home turn, no FAULT |
| OBS-U70 | the echo is still timed correctly through the shared GPIO interrupt dispatcher (`drv_gpio_irq.c`) with the barcode pin attached | driver → scanner, TEAM.md section 3 | manual | 1. Flash `make TEST=1`: the OBS on-target echo tests and BAR-U02 must pass. 2. Flash `make MQTT=1`, place an obstacle at about 200 mm and slide a barcode card under the barcode sensor while the scan runs. | OBS tests PASS; the centre echo stays within its usual spread while barcode edges arrive, with no echo FAULT and no `barcode: edge queue overflow` |
| OBS-U72 | bypass plan: pass ends short of the rear bumper when the edge is known | `obstacle_avoid.c` | auto | `sh .handoff/tools/hosttest/host.sh` | Far face plus (half width + margin) x tan(angle / 2); an unknown edge keeps full rear clearance; a short tail never lengthens the pass |
| OBS-U73 | bypass: black far from the line is not the line | `obstacle_avoid.c` (simulated) | auto | `sh .handoff/tools/hosttest/host.sh`; `line_gate_mm` 100, both sides, then a gate wide enough to reach | Too far out, the turn in and the first part of the return do not look for the line; the last part does; near enough, the turn in looks again |
| OBS-U74 | width close up from the corners' range | `obstacle_width.c` | auto | `sh .handoff/tools/hosttest/host.sh`; logged echoes | A 16 cm scan reads under 190 mm where the grid gives over 200; never raised; off beyond 200 mm, with an edge short of 60 or 120 degrees, or with an edge not found |
| OBS-U75 | width: an end behind the flat face is not the obstacle | `obstacle_width.c`, `obstacle_scan.c` | auto | `sh .handoff/tools/hosttest/host.sh`; logged echoes | Ends 125 and 157 us behind the face, the other end clear, are not edges; ends in front of it are; 100 us is the limit; with no clear end an end always stands |
| OBS-U76 | bypass: the sidestep watches the obstacle's front | `obstacle_avoid.c` (simulated) | auto | `sh .handoff/tools/hosttest/host.sh` | Both sides: the sidestep's watch faces back along the line, the turn's angle round from ahead within 30..150 degrees; losing the face at its edge does not end the watch; the pass watches at 60 or 120 as before |
| OBS-U77 | bypass: a car stopped off the line's heading turns onto it and measures | `obstacle_avoid.c` (simulated) | auto | `sh .handoff/tools/hosttest/host.sh` | Stopped 8 degrees left of the heading averaged over the last 96 mm, 250 ms after the stop the car releases, turns 8 right, stops again and rearms the scanner; the bypass ends on the new heading; once per stop. Both ways. A stall or CRITICAL during the turn still leads to a sweep, with no retry used. |
| OBS-U78 | bypass: no straightening when it would not help | `obstacle_avoid.c` (simulated) | auto | `sh .handoff/tools/hosttest/host.sh` | No turn at 3 degrees or less, over 15, with CRITICAL, without odometry, before 3 headings have been kept since following began, or after turning 15 degrees over those headings. |
| OBS-U79 | bypass: the first sidestep clears the widest obstacle on the line | `obstacle_avoid.c` (simulated) | auto | `sh .handoff/tools/hosttest/host.sh` | With 115 mm assumed out, half the car 75 and margin 60: an edge read 30 mm off the line sidesteps 250 mm, on the first plan and the re-sweep; an edge read 150 mm sidesteps 285 mm; an end is judged at 250 mm; 0 trusts the sweep (165 mm). An extra sidestep part way through keeps its own size (135 mm). |
| OBS-U80 | bypass goes round the side with more room | `OBSTACLE_SERVO_MIRRORED`, `watch_angle_for()` | manual (car) + auto (host) | MQTT image, following: put the obstacle about 30% left and 70% right of the line, then 70% left and 30% right. Host: `sh .handoff/tools/hosttest/host.sh` | Car: `ends L/R` and `hits a..b` match the obstacle's real sides, and the car goes round the side with more room both times; while passing, the watch reads the obstacle's side. Host: the watch angles in scan terms are unchanged by the setting (OBS-U76) |
| OBS-U49 | geometry kept with its result | scanner (test script seam) | auto (bench: clear path) | From a clear, released snapshot, script 3 near centre pings, no echo at both ends, fine hits at 120° and 60°, then 3 clear pings | PATH_FOUND left with centre = pivot range of the near echo ±1 mm, `left_x > 0 > right_x`, unchanged after the sweep state resets; the next CLEAR has a new sequence and zero geometry; script used up |
| OBS-U50 | scanner rearm | scanner (test command) | auto (bench: clear path) | Rearm while clear, and again during a scripted side scan, each followed by 3 scripted clear pings | Straight after each rearm: SCANNING with the returned sequence (new), stop latched, no side scan. CLEAR comes only once all 3 scripted pings are used |
| OBS-U51 | corridor sweep | scanner (test command) | auto (bench: clear path) | Script 13 positions: 1000 + 20·i µs, no echo at index 3, index 6 faulted past its retries. Then request a corridor during a scripted side scan | Corridor sequence +1, `valid_mask` all but bit 6, medians as scripted (index 3 and 6 zero), script used up, then the scanner rearms and clears. The request during the side scan is refused and publishes nothing |

A clear endpoint starts an inward edge search. A walk with no inward hit
ends at the centre, which still counts as the found edge; only a
fine-position fault or an unavailable width (invalid geometry) leaves the
edge unknown. The bypass's unknown-edge and
corridor verification paths remain necessary. OBS-U49 and the bypass cases
must be rerun after this decision change.

Critical/freshness cases (all on-target and physical results remain pending):

| ID | What is tested | Requirement / interface | Method | Steps / how | Expected result |
|---|---|---|---|---|---|
| OBS-U20 | critical predicate boundary/status handling | `obstacle_decision.c` | auto | VALID at `OBSTACLE_CRITICAL_ECHO_US - 1`, at threshold and UINT16_MAX; NO_ECHO/FAULT/PENDING | Only VALID below threshold is critical |
| OBS-U21 | critical release predicate | `obstacle_decision.c` | auto | VALID at `OBSTACLE_CRITICAL_RELEASE_ECHO_US - 1` and at threshold; NO_ECHO/FAULT/PENDING | Only VALID below release threshold blocks release |
| OBS-U22 | strict wrap-safe elapsed limit | `obstacle_decision.c` | auto | Equal, one above, and uint32 wrap: now 5, since 0xFFFFFFF0, limits 20/21 | Equality false; 21 elapsed exceeds 20 but not 21 |
| OBS-U23 | forward freshness watchdog and recovery | scanner | auto (bench: clear path) | Await clear/released snapshot; request trigger hold and await scanner acknowledgement. Save stale-event counter/time baseline. Wait from configured `OBSTACLE_FORWARD_MAX_AGE_MS` plus scheduling/transaction margin, then release hold on every exit and await fresh clear recovery. | Specific stale watchdog event increments with timestamp; UNKNOWN and stop asserted; subsequently fresh CLEAR/released. Stop alone is insufficient evidence |
| OBS-U24 | side-scan watchdog and recovery | scanner | auto (bench: board) | Place board at 150 mm when prompted. Await side scan; request trigger hold and await acknowledgement; await trigger-hold/drain acknowledgement. Save scan-timeout event baseline. Wait `OBSTACLE_SCAN_TIMEOUT_MS` plus polling margin; release hold on every exit, remove board, await centre recovery. | Specific side-timeout event increments with timestamp; sides cancelled, UNKNOWN and stop asserted; fresh CLEAR/released after removal |
| OBS-U25 | critical hysteresis through distinct centre groups | scanner → obstacle word | manual | Hold a flat board below `OBSTACLE_CRITICAL_DISTANCE_MM` until observed centre critical set. Hold separately within critical/release band until a completed centre group is observed; then hold above `OBSTACLE_CRITICAL_RELEASE_DISTANCE_MM` through another completed centre group. Record distance, centre-group observations and flags at each stage; allow complete side scan and return before each centre group. | Critical sets below threshold, remains set during band centre group, and clears only after completed above-release centre group with no blocking VALID sample. Two-second holds alone are inadequate during sides |
| OBS-U26 | confirmed ECHO disconnection fault progression | driver → scanner | manual | From fresh CLEAR/released, document electrical ECHO input level/bias, unplug ECHO and confirm input state (floating is inconclusive). Save individual fault outcomes, first stop assertion, group exhaustion and UNKNOWN timestamps. Reconnect and verify recovery. | First consumed FAULT requests stop; exhausted configured group attempts publish UNKNOWN (not necessarily the first fault or exactly three attempts). No unplug-to-event bound without instrumented disconnection origin; elapsed from confirmed first fault is separately reported |
| OBS-U27 | critical timing measurement | scanner | manual / APP_TEST instrumentation | Capture matched consumed-centre-reading and critical-set microsecond timestamps/sequence using APP_TEST instrumentation; save actual delta and timer resolution for five set transitions. Never subtract adjacent console lines. Physical arrival timing needs separate future instrumentation. | Flag sets within the same scanner update; report measured consumed-reading→critical-set interval separately from trigger→event and physical-arrival→event. No 95 ms critical deadline: forward period + transaction + polling tick is a healthy forward freshness budget only |

Calibration procedures are in [CALIBRATION.md](CALIBRATION.md). These hardware
tests are pending; firmware builds do not constitute a measurement or PASS.

| ID | What is tested | Requirement / interface | Method | Steps / how | Expected result |
|---|---|---|---|---|---|
| OBS-U28 | Distance scale and offset | raw echo → distance | manual, mode 1 | Nine distances 50–1000 mm; record outcome counts, valid medians and fit residuals; see calibration procedure | Residuals within ±max(5 mm, 2%); VALID spread ≤35 us through 500 mm; invalid samples investigated |
| OBS-U29 | Centre trim and side angles | logical → servo command | manual, modes 2/4 | Mechanically measure centre and 30/60/90/120/150; wall sweep is coarse only; trim = raw centre command −90 | Actual angles within ±3 degrees; record wall asymmetry and mounting effects |
| OBS-U30 | Servo travel and settle margin | move → usable ping | manual, video/modes 3/4 | Measure command-to-settled in both directions; resting reference and ten trials per margin; record actual trigger delays | All ten VALID echoes within ±30 us at selected and larger margins; uncertainty and reverse-direction validation recorded |
| OBS-U31 | Critical distance geometry | vehicle envelope | manual, ruler | Measure a, s, W; confirm pivot/envelope assumptions and calculate proposed critical/release thresholds | Measurements and calculation recorded; thresholds ordered; no claim of braking validation |
| OBS-U32 | Sensor limits | echo result semantics | manual, mode 1 | Minimum range, angled board, narrow and soft targets; record individual results and VALID percentages | Blind spots and demo-course risks documented; no automatic claim of reliable detection |
| OBS-U68 | Wide sweep: body, servo direction, 230 mm obstacle | 50–130° grid, `OBSTACLE_SERVO_MIRRORED`, self filter | manual, mode 5 (`digital_line_obs_cal5.uf2`, motors off) | Capture `CALWIDE` lines over MQTT, three passes each: (a) nothing within 500 mm; (b) a box 150 mm to the car's left, at the side of the front wheel; (c) the 230 mm obstacle square-on, centred 150 mm ahead, then offset 50 mm left and right | (a) every angle where the car body or wheels echo, and at what range, sets `OBSTACLE_SIDE_SELF_*`; (b) the box shows below 90° if `OBSTACLE_SERVO_MIRRORED` 0 is right, above 90° if it must be 1; (c) the 230 mm obstacle's edges fall inside 50–130° (both found) |
| OBS-U71 | Width and range on a known obstacle, fit the edge correction | OBS-U33 fit, `OBSTACLE_EDGE_CORRECTION_DEG`, OBS-U28 range fit | manual, mode 5 over 30–150° (set `OBSTACLE_CALIBRATION_MODE`, `CAL_WIDE_FIRST_DEG`/`LAST` and `MOTION_COMMAND_ACTUATION_ENABLED` 0 locally, never commit them; without that last one the car drives off), `make MQTT=1`; the boot log must say `line adapter dry run` | Car still, nothing within 500 mm in front; log the MQTT console. 2 passes with nothing in front, then the obstacle square-on and centred, its face 150, 200, then 250 mm from the servo shaft, 5 passes each (a pass is about 15 s; the pass number is the first field of each `CALWIDE` line; first and last pass at a distance are dropped). Then `python3 testing/obstacle/host/width_fit.py <log> --width <mm> --stations 150 200 250` | Range within 10 mm of each distance; both edges found at 200 and 250 mm; a correction within 0–15° gives every width within 10 %. The 10° scan grid alone limits this to about ±20 mm at these distances. A negative best correction means the echoes stop inside the true edge: record it, the car accepts 0–15° only |

For OBS-U12 additionally capture 20 open-space and 20 300 mm scope samples,
record missing rises and the driver's result, and reconcile the driver's
pre-pulse timeout origin with TRIG-falling measurements. Do not require an
unobserved all-rise response or presume every pulse below 23000 us is clear.
The current no-rise FAULT policy remains until hardware evidence supports a
separate decision. All calibration observations and normal-mode follow-up
verification are pending.

Compile and simulated regression results are software evidence only. Physical
scope observations, voltage checks and actual sensor behavior remain pending.

*Method:* **auto** = `TEST_CHECK` in code, result printed on the console;
**manual** = a person observes the result (LED, scope, meter, phone app…).

## Results

Add a new row for every run. Never edit or delete old rows. Hardware has not
been run for this implementation. Unavailable subcases are NOT RUN with a reason;
never use PASS for a build, host simulation, lost log, or unperformed procedure.

| Date | Test ID | Commit | Tester | Result | Log / evidence | Notes |
|---|---|---|---|---|---|---|
| YYYY-MM-DD | OBS-U01 | `abc1234` | | PASS / FAIL | `logs/YYYY-MM-DD_….txt` | |
| 2026-11-02 | OBS-U28 | `3ac95e6` | Kitsunez | FAIL | `logs/2026-11-02_cal_ranging.txt` | Invalid run, not used for the fit. Mode 1 (uncommitted), WIFI=none image, borrowed car with temporary trim 30. Pings 2.56 s apart and echoes about 42.7 times short: the microsecond timer ran slow; cause not yet identified |
| 2026-11-03 | OBS-U28 | `5a1b7bd` | Kitsunez | FAIL | `logs/2026-11-03_cal_ranging.txt` | Mode 1 (uncommitted), Wi-Fi image SHA256 `40de7ea0…66528ad`, trim 0. Bursts 2, 3, 4, 5, 7, 8, 10, 11, 12 = 50, 100, 150, 200, 300, 400, 500, 700, 1000 mm; bursts 1, 6, 9 discarded (board moving). All used bursts 20/20 VALID. Fit D = 0.1700 t − 18.3 mm, configured provisionally as scale 1700, offset −18. Residuals fail at 50 mm (−5.3), 200 mm (+5.6) and 500 mm (+17.2); spread above 35 us at 100 (46), 400 (43) and 500 mm (236). Re-measure 50, 200 and 500 mm, then refit |
| 2026-11-03 | OBS-U33 | `18900a9` | Kitsunez | NOT RUN | `logs/2026-11-03_width_300.txt` | Preliminary estimate, not the OBS-U33 procedure (U29/U30 and pivot pending). Detection restored to 300 mm (uncommitted). 160 mm object, 300 mm from the servo axis: two scans hit 65..115 with both edges found and read 258 and 252 mm with c = 0; a third missed the right edge (283 mm lower bound). c = 11 degrees reads 159 and 155 mm and is configured provisionally. The 2026-11-03_width.txt run at 200 mm detection found no edges |

U26 and U27 use TEST=1 after the entire automatic run ends and all trigger
holds have been released. U26 records the APP_TEST centre FAULT timestamp,
retry-before-increment and attempt diagnostic with the UNKNOWN publication;
it is a software-consumption timestamp. U25 observes completed centre decisions
through the subsequent `side scan started` event while below detection, or
CLEAR publication above detection, alongside critical set/clear events.

### 2026-11-04 side-clearance regression evidence

Base `b69616b` plus uncommitted side-clearance changes. Host U19/U52 use the
actual on-target test bodies; the extended sanitizer run checks all 65,536
centre values at echo boundaries and both candidate directions.

The isolated Pico image also includes the separate timer initialization fix
and a temporary entry point that runs pure tests with application tasks
stopped. Source delta: `logs/2026-11-04_side_diagnostic.patch` (against
`b69616b`). It was built with `make TEST=1`, placeholder Wi-Fi credentials;
no motors or sensors were driven. Firmware SHA256: `5d6ddabd0abf8274cae0b472a64538ac11dc95c499c9884b40ea44eb6a816fd4`.

| Date | Test ID | Commit | Tester | Result | Log / evidence | Notes |
|---|---|---|---|---|---|---|
| 2026-11-04 | OBS-U19 | `b69616b` + diagnostic patch above | Kitsunez | PASS | `logs/2026-11-04_side_on_target.txt` | 22 pure cases on Pico, not physical sensing; host also passes |
| 2026-11-04 | OBS-U52 | `b69616b` + diagnostic patch above | Kitsunez | PASS | `logs/2026-11-04_side_on_target.txt`, `logs/2026-11-04_side_host.txt` | Classifier agreement on Pico and host; ASan/UBSan host run |
| 2026-11-04 | OBS-U35–U38, U41–U48 | `b69616b` + diagnostic patch above | Kitsunez | PASS | `logs/2026-11-04_side_on_target.txt` | Existing bypass pure/simulated checks only; no car movement |
| 2026-11-04 | OBS-U14, U54, U49 | `b69616b` + side-clearance changes | Kitsunez | NOT RUN | — | Physical side/wall fixtures and scanner script run remain pending; not covered by the isolated pure image |
| 2026-11-06 | OBS-U71 | #136 + local mode 5 | Kitsunez | FAIL | `logs/2026-11-06_OBS-U71_run2_mqtt.txt` (not committed) | 210 mm obstacle, readings the tester identified as a wire on the left ignored at 200 and 250 mm (`--ignore 200:50-60 250:50-60`). Range PASS: medians 151/199/249 mm with a 14 mm offset, passes within 6 mm. Width with correction 0: 215/177/219 mm (+5/-33/+9), both edges found in every pass; the -33 mm at 200 mm misses the 10 %. Correction 11 gave 141/95/119 mm. Set `OBSTACLE_EDGE_CORRECTION_DEG` 0 and `OBSTACLE_SENSOR_RADIAL_OFFSET_MM` 14; offset still to confirm with a ruler. Not yet run on the car with the new values |
| 2026-11-06 | OBS-U71 (on the car) | #136, #136 | Kitsunez | PASS at this distance | `../system/logs/2026-11-06_car12_mqtt.txt`, `..._car13_mqtt.txt` (not committed) | Normal image, 210 mm obstacle on the line, car stopped about 159 mm away: width 208 and 224 mm (-1 %, +7 %), both edges found, each bypass finished in one attempt (dir 130, then dir 50) and reached `line found`. 200 mm still only checked from the OBS-U71 log. Rejoining the line not judged from the logs |
| 2026-11-07 | OBS-U72, OBS-U73 | line gate and shorter pass | Kitsunez (host) | PASS | `sh .handoff/tools/hosttest/host.sh` | Not yet run on the car. Both bypasses at 13:46 stopped for black with the row planned 140 to 200 mm short of the line, then resumed off it; no sensor trace exists during a bypass, so a cross tape is inferred. The pass also ran until the rear bumper cleared: about 130 mm further than the car needs. OBS-U55 expected pass changed from 593 to 510 mm: its 30 degree fixture now takes the shorter pass. The sim now answers a return move with the line only if it was looking for one. |
| 2026-11-07 | OBS-U74 | width from corner range | Kitsunez (host) | PASS | `sh .handoff/tools/hosttest/host.sh` | Not yet run on the car. The user reported a 16 cm obstacle reading 211 mm. At the 150 mm stop 16 and 21 cm both hit 60 and 120 degrees. Replayed on logged scans with both edges there: boots 43, 47, 48, read 211, 210, 211, become 173, 187, 180; the 21 cm scans of boots 36, 37, 42 stay at 192 to 213. Which runs used which obstacle is inferred. Only the reported width changes: the bypass uses the left and right offsets. |
| 2026-11-07 | OBS-U74 (on the car) | width from corner range, stop at 150 mm | Kitsunez | FAIL | `../system/logs/2026-11-06_dash5_mqtt.txt` boot 49 (not committed) | True widths from the tester, in order. 16 cm read 259, 256, 200 mm; 21 cm read 211, 173, 191. The 259 and 256 were an echo about 150 mm to one side, at 130 and 50 degrees: not the obstacle. All six hit 60 and 120, and the corner echoes overlap (16 cm 1064 to 1122 us, 21 cm 1036 to 1313), so at this stop the two cannot be told apart. Detection moved to 250 mm, by the tester's leave; to be measured. |
| 2026-11-07 | OBS-U74 (on the car) | detection at 250 mm | Kitsunez | FAIL | `../system/logs/2026-11-06_dash5_mqtt.txt` boot 51 (not committed) | Two scans read 267 and 328 mm, hits 70..120 and 60..120: the tester reported it worse, and it was. Which obstacle each was is not recorded. From 250 mm the beam reaches 30 degrees off centre, past either obstacle's edge. One bypass ran cleanly in about 7 s with no reverse. Back to 150 mm. |
| 2026-11-07 | OBS-U75 | end behind the face | Kitsunez (host) | PASS | `sh .handoff/tools/hosttest/host.sh` | Not yet run on the car. Of 5 logged scans with a blocked end, the 2 that read 259 and 256 mm for a 16 cm obstacle were behind the face line; the other 3 in front of it. Only the width changes: the walk goes on inward, the end stays blocked, and it happens only with the other end clear, so the side chosen does not. |
| 2026-11-07 | OBS-U74 (on the car) | back at 150 mm, end rule | Kitsunez | FAIL | `../system/logs/2026-11-06_dash5_mqtt.txt` boot 54 (not committed) | 16 cm read 213 mm, hits 60..120, both ends clear. As expected from the 150 mm stop: it cannot tell 16 from 21 cm. The second sweep, from about 200 mm, now logs its echoes (`corridor echoes`), so ordinary runs give data at a second distance for both widths. |
| 2026-11-07 | OBS-U74 (on the car) | 21 cm, second sweep logged | Kitsunez | FAIL | `../system/logs/2026-11-06_dash5_mqtt.txt` boot 56 (not committed) | 21 cm at the stop read 169, 157, 141 mm, off centre. The second sweep, by the same rules with hits counted out from the centre, gives 215, 235, 180. Closer on average, but parked 21 cm read 174 to 257 at 200 mm, so it is noisy. No change until 16 cm has run with this log. |
| 2026-11-07 | OBS-U74 (on the car) | second sweep, third size run | Kitsunez | INFO | `../system/logs/2026-11-06_dash5_mqtt.txt` boot 57 (not committed) | Stop 216, 180, 252 mm; second sweep 226, 218, 255. The tester was asked for 16 cm but did not say what ran. If it was 16 cm, neither sweep separates it from the 21 cm of boot 56 (stop 141 to 174, second sweep 180 to 235). |
| 2026-11-08 | OBS-U74 (parked) | width from a standing sweep | Kitsunez | FAIL | `../system/logs/2026-11-06_dash5_mqtt.txt` boots 61, 64 to 66 (not committed) | The test day grades width within 5 cm, flat obstacles of unknown width, no other sensor. Parked at 130 to 300 mm, with and without a 3 cm tube, at 5 and 2 degree steps: 11, 16 and 21 cm echo over the same angles at every distance, so a standing sweep holds no width. The reading follows distance: 11 cm read 200 mm at 138 and 308 at 291. The watch readings on the way past now log with odometry (`obstacle: watch`), to try measuring from known points instead. |
| 2026-11-08 | OBS-U76, OBS-U67 | sidestep faces the obstacle's front | Kitsunez (host) | PASS | `sh .handoff/tools/hosttest/host.sh` | Not run on the car. Logged watch readings at 60/120 saw the obstacle in 8 of 909 (boots 67, 68), so they cannot place its edge. The sidestep now faces the front, to see whether the face's echo ends at the edge. Its widening stays, worked out at the angle held; OBS-U67 now places its points by that angle. |
| 2026-11-08 | OBS-U77, OBS-U78 | straighten before measuring | Kitsunez (host) | PASS | `sh .handoff/tools/hosttest/host.sh` | 20 mutations caught. Not run on the car. On 74 stops from following logged from 2026-11-07 on, 69 were on a straight and 1.0 degree (median) off this heading; 7 would turn, 3.8 to 7.5 degrees. Heading and reading did not correlate on 49 straight stops (r = -0.14), so expect little change in the width itself. |
| 2026-11-08 | OBS-U77 (on the car) | straighten, then bypass | Kitsunez | FAIL | `../system/logs/2026-11-06_dash5_mqtt.txt` 18:11 boot, image 10:09:54 (not committed) | The user saw the car hit the obstacle (about centred) on the bypass. It stopped at 150 mm and straightened 6 degrees right, against a correction to the left. The scan then read hits 80..130 (corridor 90..130, nearest echo at 120), L clear, R blocked; the car went left, about 143 mm sideways, and drove on. Log has no stall or collision count; pitch 8.6 degrees at d=1444. |
| 2026-11-08 | OBS-U76 | scan's sides corrected, straightening off | Kitsunez (host) | PASS | `sh .handoff/tools/hosttest/host.sh` | `OBSTACLE_SERVO_MIRRORED` 1, from the user's sighting on 2026-11-04 that the 60 degree command faces right; `OBSTACLE_AVOID_STRAIGHTEN_MAX_DEG` 0. Not run on the car. To prove it: an obstacle clearly to one side, then the other: the car must go round the clear side. |
| 2026-11-08 | OBS-U76 (on the car) | scan's sides corrected, centred obstacle | Kitsunez | FAIL | `../system/logs/2026-11-06_dash5_mqtt.txt` 18:29 boot, image 10:26:50 (not committed) | The user saw the car hit the obstacle on the line after the Z read. Scan hits 50..110, corridor 60..100, right bypass, 173 mm sideways: the car's side 89 mm off the line. The seven bypasses in the two runs left the car's side 60, 89, 106, 128, 144, 149 and 164 mm off the line; the two reported hits were the 60 and the 89. The obstacle was on the line, so the side taken did not cause either; which side a scan angle faces is still unproven. The car's own collision count fired once, 3.3 g at 62.2 s on a sidestep, cause unknown. |
| 2026-11-08 | OBS-U79 | first sidestep clears the widest obstacle | Kitsunez (host) | PASS | `sh .handoff/tools/hosttest/host.sh` | `OBSTACLE_AVOID_EDGE_MIN_MM` 115: the car's side now ends at least 175 mm off the line. Not run on the car. |
| 2026-11-08 | OBS-U79 (on the car) | first sidestep, obstacle on the line | Kitsunez | INFO | `../system/logs/2026-11-06_dash5_mqtt.txt` 18:50 boot, image 10:47:33 (not committed) | Two bypasses left the car's side 171 and 169 mm off the line (was 60 to 164). No collision counted and no hit reported, but the user's report covered the U-turn, not the bypasses. |
| 2026-11-10 | OBS-U80 (on the car) | `OBSTACLE_SERVO_MIRRORED` 1 (#139) | Kitsunez | FAIL | `../system/logs/main.txt` 12:11 to 12:13, image built from main at 04:09:33 UTC (not committed) | Obstacle about 30% left and 70% right of the line. Three stops read it the same way, and both bypasses that ran went right (the third was stopped from the dashboard). Each scan read the obstacle past the left end of the sweep (`ends L` 937 to 1175 us, blocked) and its right edge 10 to 35 degrees right: at the first stop 57 to 91 mm right against at least 133 mm left, the real 58 and 134 mm swapped. While passing, the watch that should face the obstacle never read nearer than about 0.85 m. Each stop came 1 to 14 cm after a `JUNCTION STRAIGHT`. A swing check the same day was reported as left first, the code's order; most likely seen from in front of the car. |
| 2026-11-10 | OBS-U80 | #142 | Kitsunez (host) | PASS (host) | `sh .handoff/tools/hosttest/host.sh` | `OBSTACLE_SERVO_MIRRORED` 0, and `watch_angle_for()` no longer flips with it: the bypass's watch angles, in scan terms, are as before (OBS-U76 passes unchanged). Not run on the car. |
| 2026-11-10 | OBS-U80 (on the car) | #142, image built 04:40:05 UTC | Kitsunez | FAIL (1 of 2 passed) | `../system/logs/main.txt` from the 12:42 boot (not committed) | Run 1, obstacle 30% left and 70% right of the line: the scan read the long side on the right (`ends R` blocked, hits 60..130) and the car went round the left, the short end. Run 2, 70% left and 30% right: the car went round the long end (left). Its scan read the face's edges 20 to 30 degrees left and 30 to 40 degrees right, and the corridor sweep's nearest echo was at 100 degrees: the car stood about 10 degrees left of square to the face. It had come out of a left bend and over a cross 12 cm before the stop. A flat face stops echoing about 25 degrees off square, so the left end looked short. The first plan chose right; the re-sweep chose left. Cause: no squaring up before measuring (known limit), not the side setting. |
