SITProjects/INF2004/testing/line_follow/TEST_LOG.md

# Line following — test log

**Subsystem:** line_follow  ·  **Student ID:** <student ID>  ·  **Code:** `app_program/line_follow/`

See `testing/README.md` for how to run tests and record results.

## Test cases

Define a test here before running it. Test IDs never change.

| ID | What is tested | Requirement / interface | Method | Steps / how | Expected result |
|---|---|---|---|---|---|
| LINE-U01 | line task started and sleeps between samples | | auto | `line_follow_test.c` | `[TEST] LINE-U01 PASS` |
| LINE-U02 | each sensor's DO flips at the tape edge | IR modules, `LINE_DO_BLACK_LEVEL` | manual | Redefined 2026-11-05 for the digital DO outputs. 1. Flash `make IR_CALIBRATION=1` (motors off). 2. Move each sensor slowly from white across the tape edge at its mounted height. 3. Turn its potentiometer until the `LINE L=… R=…` line flips exactly at the edge. | white `0`, black `1` on each sensor (otherwise flip `LINE_DO_BLACK_LEVEL`); the flip happens within about 2 mm of the edge, with no chatter while held still |
| LINE-U03 | both DO pins are digital inputs (SIO, input on, output off) | TEAM.md section 2 | auto | `line_follow_test.c` | `[TEST] LINE-U03 PASS` |
| LINE-U04 | tracking decisions: debounce, lead towards a black edge while the car turns, hold the heading when it clears, held edge to search, a brief touch is a correction (never a search), lost line (sooner in a bend), search found / between / both sides / timeout, hand-back from a bypass, no wrong-way search after a pivot's overshoot, a second touch of one sensor is a bend and seeks that way, ended by the other sensor, a cross junction straight on (tracking carries on) / LEFT / RIGHT / U-turn (exact pivot, sensors ignored, then straight on) / a pivot that never ends stops, the tape crossing from one sensor to the other (a correction too far) starts no search, an edge turning black together with the other is a fresh correction, a model of the car (sensors 130 mm ahead, turn lag) following the 100 mm radius curve fitted to car10 and a 200 mm curve met 8° off, with the sensors 20 and 36 mm apart, holding a straight, travel with the tape under both sensors is no held edge | IF-04 | auto (host) | `sh testing/line_follow/host/run.sh` in the dev container | `0 failure(s)` (LT01..LT22 PASS) |
| LINE-U05 | the car runs straight between corrections on a 2 m straight | issue 1, IF-04 | manual | 1. Flash `make MQTT=1`. 2. Start the car on a 2 m straight with the tape between the sensors. 3. Watch the corrections over the 2 m and mark the side-to-side deviation. | no visible weave; short corrections only when a sensor touches the tape; the car stays straight between them; no `SEARCH` |
| LINE-U06 | a 90° corner each way and a curve | IF-04 | manual | Same image: run through a left and a right 90° corner and the course's tightest curve. Save the `line SEARCH_…`/`TRACK` lines. | the curve is followed without `SEARCH`; each corner is either driven round while the edge reads black, or a held edge (or the line lost) starts `SEARCH` towards the corner, the pivot ends with the tape between the sensors, and following resumes on the new leg with no `SEARCH` the other way |
| LINE-U07 | a lost line is searched for both ways and then stops | IF-04 | manual | Same image: end the tape. | `SEARCH` towards the last edge up to 120°, then the other way, then `line STOP` and the car brakes; putting a sensor on the tape restarts `TRACK` |
| LINE-U08 | cross junctions: straight on by default, and each turn | IF-04, IF-08 | manual | 1. Flash `make MQTT=1`; run across a cross: `line JUNCTION STRAIGHT`, the car keeps tracking over the crossing and follows on. 2. For each of LEFT, RIGHT and UTURN, set the barcode before the cross to it on the dashboard (`tools/dashboard/car_dashboard.py`), press Start and run into the cross. Save the `line …` and `LT …` lines. | straight: no `SEARCH`; each turn: `line JUNCTION <turn>`, the car stops over the crossing, pivots exactly 90° (180° for a U-turn), ignoring the sensors, then `line TRACK` and it drives straight on along the new heading |
| LINE-U09 | the left and right line sensors match the car's own sides | IF-04, `LINE_LEFT_PIN`, `LINE_RIGHT_PIN` | manual | 1. Flash `make MQTT=1 IR_CALIBRATION=1` (motors stay off). 2. Car on the white floor, both sensors reading 0. 3. Stand **behind** the car, facing the way it drives. 4. Slide black tape under the sensor on your left only and hold it 3 s, then the one on your right only. | your left gives `LINE L=1 R=0`, your right `LINE L=0 R=1`; the reverse means the pins are swapped. (2026-11-06: the first check did not say which way to face, so it did not settle this) |

*Method:* **auto** = `TEST_CHECK` in code, result printed on the console;
**manual** = a person observes the result (LED, scope, meter, phone app…).

## Results

Add a new row for every run. Never edit or delete old rows.

| Date | Test ID | Commit | Tester | Result | Log / evidence | Notes |
|---|---|---|---|---|---|---|
| YYYY-MM-DD | LINE-U01 | `abc1234` | | PASS / FAIL | `logs/YYYY-MM-DD_….txt` | |
| 2026-11-06 | LINE-U04 | #136 + slow pass | Kitsunez (host) | PASS | `sh testing/line_follow/host/run.sh` | LT23..LT28 added for the slow pass over a barcode. Model only, not run on the car: heading within +-3.0 deg through a creep at 30 mm/s, met 3 deg off. `motion_command.c`'s reverse has no host test. |
| 2026-11-06 | LINE-U04 | #136 + bend crossing | Kitsunez (host) | PASS | `sh testing/line_follow/host/run.sh` | Not run on the car. LT29..LT33 added. A tape crossing both sensors and leaving on the side the car has turned 15 deg towards now seeks that way: 2026-11-06 logs had 13 of 16 such crossings exit left, a median 203 mm of white after them, 4 never finding the tape. Replayed over the logged crossings it fires on all 4; the model's 81 curve cases go from 62 to 65. |
| 2026-11-06 | LINE-U08 | #136 | Kitsunez | PASS | `../system/logs/2026-11-06_dash5_mqtt.txt` (not committed) | 21:36 run: `A` then LEFT, `F` then UTURN, read and acted on. Pivots with clean wheels: compass 78 deg for 90 and about 192 for 180. The bend crossing rule fired once and the tape returned in 36 mm. |
| 2026-11-07 | LINE-U05 | #136 | Kitsunez | INFO | `../system/logs/2026-11-06_dash5_mqtt.txt` (not committed), 2026-11-07 11:12 | Car pushed by hand round the wide U: +171 deg over about 440 mm, 105 to 130 mm radius at the axle, about 37 deg/s at 80 mm/s. Line sensors are not logged while stopped. |
| 2026-11-07 | LINE-U04 | #136 + crossing hold | Kitsunez (host) | PASS | `sh testing/line_follow/host/run.sh` | The swing rule (#136) is removed: on the car it fed a +-11 degree wobble on straights, 10 heading reversals per metre against 2 to 4 before. LT35 pins that; LT36 to LT38 cover holding the heading over a crossing. Not run on the car. |
| 2026-11-07 | LINE-U02 | #136 | Kitsunez | PASS | hand measurement, ruler | Slide across 19 mm tape: left black for about 10 mm, right about 12 mm. The sensors nearly match, so they do not explain the left and right difference. |
| 2026-11-07 | LINE-U04 | #136 + gentle counter touch | Kitsunez (host) | PASS | `sh testing/line_follow/host/run.sh` | LT39 to LT41 added. Not run on the car. In a bend the other sensor steers back 5 degrees, not 15, for 40 mm. Car run at 12:18 before this: straights calm (2.0 heading reversals per metre) and junctions clean, but right touches swung left bends back 15 to 28 degrees. Model U: 52 to 54 of 54. |
| 2026-11-07 | LINE-U04 | #136 + gentle touch out of a bend | Kitsunez (host) | PASS | `sh testing/line_follow/host/run.sh` | LT42 to LT45 added. Not run on the car. Both left U exits at 12:57 and 12:58 left the straight: the right touch went to full lead after 40 mm, the car swung 15 to 17 degrees and the tape went out on the left. A touch begun against a bend now stays at 5 degrees for 100 mm, and one clearing after 60 mm ends the bend. Replayed logged sensors: lead stays -5 where it was -15. Model with the right sensor 0.34 s slow: left U 0 to 68 of 324; healthy sensor 262 to 267, right turns unchanged. |
| 2026-11-07 | LINE-U04 | #136 + bend exit retuned for the fixed sensor | Kitsunez (host) | PASS | `sh testing/line_follow/host/run.sh` | LT46, LT47 added. Not run on the car. Right sensor now 12 mm on a crossing. At 120 mm/s (14:16) the car came out of a right turn at -298, a 52 mm left touch left the bend on (limit 60), and it spun past -430 on white. Bend end 60 to 40 mm, counter lead 5 to 6, and the side of that touch becomes the last side seen, so a search goes the right way. Replayed logged sensors: the bend ends where it used to spin, and stays on through the right U, though one touch there is 37 mm. Lead 10 passed more in the model with healthy sensors but failed LT44 (U 1 of 324 with a slow sensor), so 6. |
| 2026-11-07 | LINE-U04 | #136 + junction turn point | Kitsunez (host) | PASS | `sh testing/line_follow/host/run.sh` | Not run on the car. Run at 120 mm/s: about 25 m driven. One right junction ended its pivot on white and the car ran 600 mm without a touch, through the right curve beyond; the pass before it ended on the right sensor and followed. Over 16 logged turns the axle stopped 5.5 to 15.5 mm past the centre (median 11 at 80 mm/s, 12 at 120), 15.5 on the miss. LINE_JUNCTION_CENTRE_MM 140 to 130. Tape past the right sensor after a small pivot error is inferred; there is no measure of true heading there, the compass swings with the location. |
| 2026-11-07 | LINE-U04 | follow speed 120 mm/s | Kitsunez (host) | PASS | `sh testing/line_follow/host/run.sh` | The user's choice after driving it. LT19 now uses the car's 30 mm sensor gap: all four curves pass at 120, and 20 mm, which lost them, is not this car. LT44 stays at 80 mm/s: at 120 a sensor 0.34 s slow fails at every lag tried. LT48 added at the follow speed with the sensors as now. Not covered at 120: the model fails the U from 0.35 s of turn lag or 0.1 s of sensor delay, and the car's lag was measured at 0.25 to 0.5 s. LINE_CURVE_TOUCH_MM stays 80: 120 halved the cross-tape course in the model. |
| 2026-11-07 | LINE-U04 | hump slows the car | Kitsunez (host) | PASS | `sh testing/line_follow/host/run.sh` | LT49 to LT59 added. Not run on the car. The user's request, to spare the sensors. Only on a straight, held until level ground, at most 8 s. In the 2026-11-07 boot 43 log 24 of 37 lean starts were on a straight, so expect some short needless slow-downs; the real hump looks the same as those for its first 50 mm, and waiting to be sure would slow the car after the peak. At 120 mm/s the hump state starts 40 to 61 mm up the ramp, so the climb to there is at full speed. |
| 2026-11-07 | LINE-U04 | turn allows for an askew junction | Kitsunez (host) | PASS | `sh testing/line_follow/host/run.sh` | LT60 to LT65 added. Not run on the car. The user reported left turns at cross junctions missing the line. Over 23 logged left and right turns, 4 met the tape 4 mm or more askew, away from the new line: none saw the tape as the pivot ended, 3 ran over 150 mm with no touch. The pivot now allows asin(skew / 30 mm). Two left turns that met the tape square also ran 198 and 399 mm with no touch; that is not explained. A pivot that searches for the tape was left out: 7 turns that did not see it were fine. |
| 2026-11-07 | LINE-U04 | crossings at 120 mm/s | Kitsunez (car and host) | PASS (host) | `testing/system/logs/2026-11-06_dash5_mqtt.txt` boots 37 to 50, `sh testing/line_follow/host/run.sh` | LT66 to LT68 added. Not run on the car. The user reported missed junctions. Both misses in boots 49 and 50 read 11 mm askew against a limit of 10: one with a single sample of overlap, one met just as a search found the tape. Replaying the logged sensors through `line_track.c` reproduced 53 of 58 logged junctions; skew 14 with one sample adds 4 crossings and no false ones. A rule for a sensor already on the line was tried and dropped: 3 of its 4 extra junctions were in bends. |
| 2026-11-07 | LINE-U04 | left turn aimed by the old line | Kitsunez (car and host) | FAIL (car, last image), PASS (host) | `testing/system/logs/2026-11-06_dash5_mqtt.txt` boot 53, `sh testing/line_follow/host/run.sh` | LT60 to LT65 rewritten, LT69 to LT73 added. Not run on the car. The user reported left turns missing the line or turning too little. The skew correction of #136 is removed: it took 19 degrees off one left turn, a sensor already on the line read as skew, and it went the wrong way in all 3 recent turns it touched. A left pivot now takes the line's direction from the right sensor leaving the old line. Three failed left turns reached a crossing with no touch before it, showing 10, 10 and 8 degrees short; the sweep read 12, 9 and 9. Right turns stay a plain 90: nothing independent checks the reading for them, and they work. |
| 2026-11-07 | LINE-U04 | near sensor ends a bypass return | Kitsunez (car and host) | FAIL (car, last image), PASS (host) | `testing/system/logs/2026-11-06_dash5_mqtt.txt` boot 54, `sh testing/line_follow/host/run.sh` | LT74 to LT78 added. Not run on the car. The user reported the bypass missing the line. Placing each black on the floor from odometry: two sensors at one x are a crossing tape, at one y the main line. The far sensor on a crossing tape ended the return; the line was at y -13 and the car stopped at -82. Over 10 logged returns the near sensor alone leaves 5 as they were and brings 4 closer (boot 42 from 89 mm off to 1, 47 from 73 to 36, 51 from 104 to 70, 54 from 69 to 15), and in boot 53 from 22 to 1. A tighter gate on odometry was dropped: the line was 60 mm from where odometry put it in boot 49, and that return was right. |
| 2026-11-07 | LINE-U04 | finding the line again | Kitsunez (car and host) | FAIL (car, last image), PASS (host) | `testing/system/logs/2026-11-06_dash5_mqtt.txt` boot 55, `sh testing/line_follow/host/run.sh` | LT79 to LT87 added. Not run on the car. The near-sensor rule worked: all 6 returns ended on the main line, an off-centre obstacle included. The user reported a lost car not rejoining. Two touches just after a bypass read as a bend, and seeking it drove the car in circles, over a full lap, with each lap's tape resetting the lost-line check. A bypass now ends with a search, touches read as no bend for 300 mm, circling starts a search, and crossing tapes no longer count as seeing the line: 9 checks in 86 m of logged driving, up from 3. |
| 2026-11-07 | LINE-U04 | right turns aimed by the old line too | Kitsunez (car and host) | FAIL (car, last image), PASS (host) | `testing/system/logs/2026-11-06_dash5_mqtt.txt` boot 56, `sh testing/line_follow/host/run.sh` | LT62 rewritten, LT88 to LT90 added. Not run on the car. In the same run bypasses, rejoin searches, left turns and the hump all worked: hump 11 mm high at about 30 mm/s, counted. The user reported a missed right curve. The right turn before it met the junction crooked: the left sensor left the old line 32 degrees into the pivot, not 7 to 12, so a plain 90 ended about 18 short and the car ran 508 mm blind past a curve the 5 earlier passes met at 370 mm. Recent right turns fit the reading: swept 7, 10 and 12 degrees, left sensor touching at 29, 84 and 130 mm. |
| 2026-11-07 | LINE-U04 | no bends in a slow pass | Kitsunez (car and host) | FAIL (car, last image), PASS (host) | `testing/system/logs/2026-11-06_dash5_mqtt.txt` boot 57, `sh testing/line_follow/host/run.sh` | LT28 rewritten, LT91 to LT93 added, LT51 no longer asks for a bend flag, which a slow pass cannot now set. Not run on the car. The user reported the car going off track after reading a barcode, and on the next pass missing the junction. Both were bend seeking in the creep: a few touches read as a bend, and the car seeked it with both sensors white. Going off track was the same seek carrying on at 120 mm/s; the next pass swung 18 degrees and failed to decode (`FAIL ratio`, all 29 elements), so the car had no turn to make. All 9 of 44 logged creeps with 11 degrees of swing or more were seeking. |
| 2026-11-08 | LINE-U04 | barcode bars ignored in a creep | Kitsunez (car and host) | FAIL (car, last image), PASS (host) | `testing/system/logs/2026-11-06_dash5_mqtt.txt` boot 69, `sh testing/line_follow/host/run.sh` | LT94 to LT98 added. Not run on the car. The user reported the car bouncing on the line until the line sensor read the barcode, which is left of the line. In the creep from 4565 mm the car was left of the line: the right sensor kept touching the tape and the left read the bars, with both black for 108 mm. That gave 4 false junctions, and both black reads as centred, so the car stopped correcting; the barcode did not decode. In a creep, black that begins on the left while the right is already on the tape is now the bars, ignored until it clears, even past the creep's end; the right leaving the tape meanwhile turns the car right. Replayed logged sensors: the old code gives the 4 logged junctions, the new one only the last, where the left went black from white and reads as tape; through the 108 mm it leads right where it held. Not covered: a crossing met in a creep with the right on the tape is lost. In this log the creeps that read ended 100 to 195 mm before their junctions. |
| 2026-11-08 | LINE-U04 | barcode bars ignored on either side | Kitsunez (car and host) | FAIL (car, last image), PASS (host) | `testing/system/logs/2026-11-06_dash5_mqtt.txt` boot 70, `sh testing/line_follow/host/run.sh` | LT94 to LT98 now run with the bars on either side; LINE_BARCODE_ON_LEFT is removed. Not run on the car. The user has a barcode right of the line too, 2 cm out like the left ones, and saw the right line sensor read it. In boot 70's creep the right sensor went black with the left white, then stayed black while the car turned 42 degrees right towards it, so it was not the tape, and the car left the line. The guard cannot catch that pass: the left sensor never reached the tape first, so the right reached the bars before the left reached the tape. Replayed logged sensors: boot 69's creep now gives no junctions, its last (4980 mm) being the left on the tape first and the right joining; boot 70 is unchanged. |
| 2026-11-08 | LINE-U04 | creep holds the line's heading | Kitsunez (car and host) | FAIL (car, last image), PASS (host) | `testing/system/logs/2026-11-06_dash5_mqtt.txt` runs at 14:14 and 14:18, `sh testing/line_follow/host/run.sh` | LT94, LT95 and LT97 now expect the lean; LT99 to LT102 added. Not run on the car. The user reported the car veering left and right onto the barcodes. In the 14:18 creep the car started 7 degrees left of the line, having braked while turning; the left sensor met the left barcode before the right met the tape, so the bar rule took each for the other, and a lead that runs on while a sensor stays black turned the car from 4 to 47 degrees. After the read the swing was taken for a bend and the car came round 180 degrees. A creep now holds the line's heading, averaged over about 100 mm before the brake, leans 5 degrees towards a sensor on the tape and turns back along the line when it clears. Replayed logged brakes: line heading 5 where that creep started at 12, -276 against -273 just after a search, -495 against -490. Not covered: the host model already crept within 3 degrees, so the gain is not measured there; odometry drifts about 1 degree per 100 mm on a straight, which the lean has to absorb in a long creep; and the line sensors still cross the barcodes at full speed before the brake. |
| 2026-11-08 | LINE-U04 | going back past a barcode after its U-turn | Kitsunez (car and host) | FAIL (car, last image), PASS (host) | `testing/system/logs/2026-11-06_dash5_mqtt.txt` from 12:24, `sh testing/line_follow/host/run.sh` | LT103 to LT109 added, 12 mutations caught. 10 of 11 returns turned 36 to 154 degrees off the line at full speed, the right sensor on the bars of the barcode just read. Replaying 25 logged returns open loop, the target stays within 5 degrees of the line with no false junctions. Not run on the car. |
| 2026-11-08 | LINE-U04 | going back past a barcode after its U-turn, on the car | Kitsunez | PASS | `testing/system/logs/2026-11-06_dash5_mqtt.txt` 17:11 boot, image 07:57:33 (not committed) | 19 of 19 returns stayed within 6 degrees of the line's heading; 20 slow passes read (one Z line lost to dropped log lines); no false junction or search on a return. |
| 2026-11-08 | LINE-U04 | steering from a read to its crossing | Kitsunez (host) | PASS | `sh testing/line_follow/host/run.sh` | LT110 to LT116 added, 8 mutations caught. On the 17:11 run 5 of 9 logged Z passes met the crossing 8 to 17 mm apart after a full-lead swing, and the 17 mm one was missed. Replaying all 19 logged stretches open loop, the same crossings fire in the same places and the target stays within 5 degrees of the line up to the crossing. Not run on the car. |
| 2026-11-08 | LINE-U04 | a U-turn's pivot ends on the track | Kitsunez (car and host) | FAIL (car, last image), PASS (host) | `testing/system/logs/2026-11-06_dash5_mqtt.txt` 18:50 boot, image 10:47:33 (not committed), `sh testing/line_follow/host/run.sh` | LT117 to LT119 added, 3 mutations caught. The user saw the car move off without being on the track. The right sensor was on the tape at the junction and left it 7 degrees into the pivot, which cut the target by 6, and the car lost the line about 400 mm on. 3 of 41 logged U-turns were cut 5 to 9 degrees from such a start, and none of them saw the tape before stopping. Not run on the car. |
| 2026-11-08 | LINE-U04 | a clean slow pass reaches its crossing | Kitsunez (car and host) | FAIL (car, last image), PASS (host) | `testing/system/logs/2026-11-06_dash5_mqtt.txt` 18:58 boot, image 10:57:34 (not committed), `sh testing/line_follow/host/run.sh` | LT120 and LT121 added. The user saw the car miss the junction and go off diagonally right. With no touch from the start of the creep over A, LINE_STRAIGHT_LOST_MM ran out 10 mm before the crossing (601 and 600 mm from the creep's start on the two logged cases, 2 of 8 reads since the steering after a read went to 5 degrees); the search took the crossing tape for the line and the car left at -43. Not run on the car. |
| 2026-11-09 | LINE-U04 | a crossing met askew with a turn waiting, and no search in a slow pass | Kitsunez (host) | PASS (host), not run on the car | `sh testing/line_follow/host/run.sh` | LT122 to LT126 added, 5 mutations caught |
