SITProjects/INF2004/testing/README.md

# Testing

All test records for the project live in this folder. A test only counts as
done when it is **written down here with its result and a saved log**.

```
testing/
├── README.md              this guide
├── obstacle/              one folder per subsystem, kept by its owner
│   ├── TEST_LOG.md        test cases + results
│   └── logs/              saved console output, photos, scope captures
├── ...
├── communication/
├── integration/           tests across two or more subsystems (shared)
└── system/                tests of the whole product against its requirements (shared)
```

## Three levels of test

| Level | ID format | Tests what | Written by | Where |
|---|---|---|---|---|
| Unit | `OBS-U01`, `MOT-U01`, `LINE-U01`, `TER-U01`, `COM-U01`, … | one subsystem on its own | the subsystem's owner | `<name>/TEST_LOG.md` |
| Integration | `INT-01`, … | an interface between subsystems (TEAM.md section 5) | the owners on both sides | `integration/TEST_LOG.md` |
| System | `SYS-01`, … | the finished product against a requirement | whole team | `system/TEST_LOG.md` |

Test IDs never change and are never reused, even if a test is dropped.

## How to run and record a test

1. **Define it first.** Add a row to the *Test cases* table in the right
   `TEST_LOG.md`: ID, what it checks, how, and the expected result.
2. **Automate it if you can.** Add a `TEST_CHECK` with the same ID to
   `app_program/<name>/<name>_test.c` (see `app_program/test_report.h`).
   A test that needs eyes or instruments (an LED blinks, a motor turns, a
   scope shows 1 kHz) is a *manual* test. Write its steps in the table instead.
3. **Build the test image and flash it.**
   ```sh
   cd build_make
   make TEST=1 -j8        # -> mtk3pico_smp1_usb_cdc_wifi_lwip_test.uf2
   ```
   The test image runs every subsystem's tests at power-up and prints one
   `[TEST] <ID> PASS|FAIL` line per check. (A normal `make` leaves the tests out.)
4. **Save the console output** to `logs/`, named `YYYY-MM-DD_<what>.txt`:
   ```sh
   # macOS (find the port name with: ls /dev/cu.usbmodem*)
   cat /dev/cu.usbmodem1101 | tee ../testing/obstacle/logs/2026-10-14_unit.txt
   # Linux / WSL with usbipd
   cat /dev/ttyACM0 | tee ../testing/obstacle/logs/2026-10-14_unit.txt
   ```
   Start the command first, then reset the Pico. Press Ctrl-C when it is done.
   On Windows with PuTTY, use *Session → Logging → All session output*.
   For manual tests, save photos or scope screenshots in `logs/` the same way
   (keep each file under a few MB). Videos go in `videos/` instead (see below).
5. **Record the result.** Add a row to the *Results* table: date, test ID,
   the commit you tested (`git rev-parse --short HEAD`), who ran it,
   PASS/FAIL, and the log file. Commit the log and the table together.

## Videos of tests and demos

A manual test (an LED, a motor, a sensor reacting) is best shown with a short
video. Record 15–60 s showing the test ID and the hardware, share it as an
**unlisted YouTube** link (the only way videos are shared), list it in
**`videos/README.md`**, and put the link in the *Log / evidence* column of
the test's result row. `videos/README.md` explains how.

## Rules

- **Never edit or delete an old result.** If a test fails, record the FAIL,
  fix the code, re-run, and add a new PASS row. The history is the evidence.
- **Always record the commit.** A result is meaningless without the exact
  code it was run on. Commit your work *before* testing.
- **A FAIL needs a note** saying what went wrong and, later, which commit fixed it.
- Before merging a change into `main`, re-run your subsystem's unit tests.
  Before a demo or hand-in, run every test and record the full set.
