SITProjects/INF2004/app_program/obstacle/obstacle_config.h

/**
 * @file obstacle_config.h
 * @brief Wiring, scan settings and calibration for obstacle sensing.
 *
 * Detection thresholds and timing defaults require physical validation.
 * Pin assignments must agree with TEAM.md and the actual wiring.
 */

#ifndef OBSTACLE_CONFIG_H
#define OBSTACLE_CONFIG_H

/* Public includes. */
#include "../robot_types.h"
#include "config.h"

/* Public types, constants, and macros. */

/* Vehicle dimensions. */
#define OBSTACLE_VEHICLE_WIDTH_MM 127u
#define OBSTACLE_VEHICLE_LENGTH_MM 162u

/* Wiring: planned allocation; confirm before changing the hardware. */
#define OBSTACLE_TRIG_PIN 16u
#define OBSTACLE_ECHO_PIN 17u
#define OBSTACLE_SERVO_PIN 12u

/* Task configuration: tScan, design freeze 8 + 3 (TEAM.md section 4). */
#define OBSTACLE_PRI_SCAN 11
#define OBSTACLE_UPDATE_PERIOD_MS 10u

/* Mechanically permitted sweep. Verify the complete arc on the car. */
#define OBSTACLE_SWEEP_FIRST_DEG ROBOT_OBSTACLE_SWEEP_FIRST_DEG
#define OBSTACLE_SWEEP_LAST_DEG ROBOT_OBSTACLE_SWEEP_LAST_DEG
#define OBSTACLE_SWEEP_STEP_DEG ROBOT_OBSTACLE_SWEEP_STEP_DEG
#define OBSTACLE_CENTRE_DEG 90u

#define OBSTACLE_SWEEP_POINTS ROBOT_OBSTACLE_SWEEP_POINTS

#define OBSTACLE_CENTRE_INDEX                                                  \
    ((OBSTACLE_CENTRE_DEG - OBSTACLE_SWEEP_FIRST_DEG) / OBSTACLE_SWEEP_STEP_DEG)

/* Scan angles the sensor holds to watch the obstacle side while passing:
 * 30 degrees off the heading, inside the 50..130 degree sweep. */
#define OBSTACLE_WATCH_LEFT_DEG 60u
#define OBSTACLE_WATCH_RIGHT_DEG 120u

/*
 * On the sidestep the sensor faces back along the line at the obstacle's
 * front, the turn's angle round from ahead, within these servo limits. A sweep
 * from standing cannot tell 11, 16 and 21 cm apart (2026-11-08), but crossing
 * the front, the face's echo should end at its edge however wide the beam.
 */
#define OBSTACLE_WATCH_MIN_DEG 30
#define OBSTACLE_WATCH_MAX_DEG 150

/* Side positions retain the median of nonzero samples. */
#define OBSTACLE_PINGS_PER_ANGLE 3u

/*
 * Fine sweep: after both coarse ends, walk inward one grid step at a time
 * from each end that missed the obstacle, one ping per angle.
 */
#define OBSTACLE_FINE_PINGS_PER_ANGLE 1u

/* Centre confirmation: first near ping plus two usable pings, majority wins. */
#define OBSTACLE_CENTRE_CONFIRM_PINGS 3u
#define OBSTACLE_CENTRE_NEAR_VOTES 2u

/*
 * Two extra attempts per side position or centre group, not per ping.
 * Invalid measurements must not cause an unbounded scan.
 */
#define OBSTACLE_EXTRA_ATTEMPTS_PER_ANGLE 2u

/* Centre trigger-to-trigger schedule; late polls do not replay missed pings.
 * The driver independently enforces minimum spacing across all angles.
 */
#define OBSTACLE_FORWARD_PERIOD_MS 60u
#define ULTRASONIC_PING_INTERVAL_US 60000u

/* Trigger waveform: preserve the existing driver values. */
#define ULTRASONIC_TRIG_SETTLE_US 2u
#define ULTRASONIC_TRIG_PULSE_US 10u

/*
 * Stored pulse width. Keep timestamps as uint32_t for elapsed-time maths.
 * Fifteen bits hold 0..32767; zero is reserved by the proposed interface.
 */
#define ULTRASONIC_ECHO_BITS 15u
#define ULTRASONIC_ECHO_MAX_US ((1u << ULTRASONIC_ECHO_BITS) - 1u)

/*
 * Two-part measurement timeout.
 *
 * Start timeout: provisional; measure trigger-to-rise delay on the scope.
 * Pulse timeout: maximum measurable in-range pulse, from the rising edge.
 * Crossing it reports NO_ECHO (beyond range) under the team policy. Some
 * modules may hold ECHO high longer in open space; scope validation is open.
 * A high input at a later trigger attempt remains a separate FAULT.
 */
#define ULTRASONIC_START_TIMEOUT_US 2000u
#define ULTRASONIC_PULSE_TIMEOUT_US 23000u

/* Kernel timer period; must match CNF_TIMER_PERIOD in config/config.h. */
#define OBSTACLE_TICK_MS 10u

/*
 * Sound scale (millimetres per 10000 echo microseconds) and signed offset:
 * provisional OBS-U28 fit, 2026-11-03_cal_ranging.txt, D = 0.1700 t - 18.
 * Not accepted yet: residuals at 50, 200 and 500 mm exceed the rule; refit
 * after re-measuring those distances.
 */
#define OBSTACLE_SOUND_MM_PER_10K_US 1700u
#define OBSTACLE_ECHO_OFFSET_MM (-18)

/*
 * Convert D to ceil((D - offset) * 10000 / scale), for 0..400000 mm
 * with D strictly above offset. Signed 64-bit promotion before subtraction
 * handles negative offsets even when D is unsigned. The checked scale and
 * offset bounds keep the numerator below 13 billion, avoiding overflow.
 * Keep this cast-free: compile-time threshold checks also use it in #if.
 */
#define OBSTACLE_MM_TO_ECHO_US(mm)                                             \
    (((((mm) + 0LL - OBSTACLE_ECHO_OFFSET_MM) * 10000LL) +                     \
      (OBSTACLE_SOUND_MM_PER_10K_US - 1LL)) /                                  \
     OBSTACLE_SOUND_MM_PER_10K_US)

/*
 * Candidate thresholds, pending stopping-distance tests. Edit only the
 * millimetre values; the echo equivalents are derived.
 *
 * Detection: 150 mm -> 989 us. A nearer centre reading requests a stop.
 * 250 mm was tried on 2026-11-07: the beam reaches well past the obstacle's
 * edges from there, and the width read 267 and 328 mm, against 161 to 219 at
 * 150 mm. The bypass was quicker, needing no reverse and second sweep.
 */
#define OBSTACLE_DETECT_DISTANCE_MM 150u
#define OBSTACLE_DETECT_ECHO_US                                                \
    OBSTACLE_MM_TO_ECHO_US(OBSTACLE_DETECT_DISTANCE_MM)

/* Critical: 80 mm -> 577 us. One nearer centre reading sets the flag. */
#define OBSTACLE_CRITICAL_DISTANCE_MM 80u
#define OBSTACLE_CRITICAL_ECHO_US                                              \
    OBSTACLE_MM_TO_ECHO_US(OBSTACLE_CRITICAL_DISTANCE_MM)

/*
 * Critical release: 100 mm -> 695 us, the Week 6 minimum stopping gap.
 * The flag clears only after a complete centre group with no VALID reading
 * nearer than this. 80..100 mm is the hysteresis band.
 */
#define OBSTACLE_CRITICAL_RELEASE_DISTANCE_MM 100u
#define OBSTACLE_CRITICAL_RELEASE_ECHO_US                                      \
    OBSTACLE_MM_TO_ECHO_US(OBSTACLE_CRITICAL_RELEASE_DISTANCE_MM)

/*
 * Width sweep: a VALID reading is on the obstacle (HIT) when it is nearer
 * than a flat face square to the heading at the centre range would read at
 * that angle (centre echo / cos of the angle off centre) plus this margin,
 * 466 us (about 80 mm). Without the cosine a wide wall 300 mm ahead would
 * read 534 us farther at the 50 and 130 degree ends and look clear.
 */
#define OBSTACLE_EDGE_JUMP_US 466u

/*
 * An end hit this far behind that flat face, with the other end clear, is
 * something beside the obstacle: on 2026-11-07 ends 125 and 157 us behind it
 * read a 16 cm obstacle as 256 and 259 mm. The width walks on inward, and the
 * end stays blocked for choosing a side. Ends on the obstacle read 30 to
 * 245 us in front of it.
 */
#define OBSTACLE_END_BEHIND_US 100u

/*
 * Servo timing: preserve the existing uncalibrated one-second wait.
 * Replace these after measuring travel and settling under actual load.
 *
 * wait_ms = ceil(delta_deg * travel_ms_per_60_deg / 60) + margin_ms
 */
#define OBSTACLE_SERVO_TRAVEL_MS_PER_60_DEG 120u
#define OBSTACLE_SERVO_SETTLE_MARGIN_MS 150u

/*
 * Width geometry from OBS-U71 (2026-11-06, 210 mm obstacle at 150, 200 and
 * 250 mm from the servo shaft). Pivot offset is signed, along the sensor's
 * radial measurement axis: 14 mm puts all three ranges within 1 mm. A ruler
 * gives about 20 mm (sensor 80 mm, servo about 60 mm from the axle); the
 * fit stays, as it also absorbs the provisional OBSTACLE_ECHO_OFFSET_MM.
 * A lateral mounting offset needs a separate coordinate transform.
 * A found edge lies half a step outside its hit; the edge correction then
 * moves it toward the obstacle centre. On a flat face at these ranges the
 * echoes stop at or inside the true edge, so no correction is needed: 0
 * gives +5, -33 and +9 mm where 11 gave -69, -115 and -91 mm. The -33 mm at
 * 200 mm is the 10 degree grid. Corrections above the maximum make the
 * width unavailable.
 */
#define OBSTACLE_SENSOR_RADIAL_OFFSET_MM 14.0f
#define OBSTACLE_EDGE_CORRECTION_DEG 0.0f
/*
 * Close up, both edges echo out to the same grid angle whatever the width: 16
 * and 21 cm both hit 60 and 120 degrees at the 150 mm stop and read 211 mm
 * (2026-11-07). The echo there comes from the corner, so the range gives its
 * place: obstacle_width_close_up(). Only within this range, in mm, and with
 * both edges this far off centre, in grid steps: further away the outer hits
 * are the face, not the corners, and it read a 210 mm obstacle as 117.
 */
#define OBSTACLE_WIDTH_CLOSE_MAX_MM 200.0f
#define OBSTACLE_WIDTH_CLOSE_STEPS 3u
#define OBSTACLE_EDGE_CORRECTION_MAX_DEG 15.0f

/*
 * Freshness. While the stop request is released, going longer than this
 * without a usable centre reading re-asserts it. Three missed forward pings
 * plus two ticks of scheduling jitter: 3 * 60 + 2 * 10 = 200 ms. A healthy
 * sensor peaks at forward period + transaction + tick = 95 ms.
 */
#define OBSTACLE_STALE_MISSED_PINGS 3u
#define OBSTACLE_FORWARD_MAX_AGE_MS                                            \
    ((OBSTACLE_STALE_MISSED_PINGS * OBSTACLE_FORWARD_PERIOD_MS) +              \
     (2u * OBSTACLE_TICK_MS))

/* One ultrasonic transaction (start + pulse timeout), rounded up: 25 ms. */
#define OBSTACLE_TRANSACTION_MS                                                \
    ((ULTRASONIC_START_TIMEOUT_US + ULTRASONIC_PULSE_TIMEOUT_US + 999u) / 1000u)

/* Driver ping spacing, rounded up to milliseconds: 60 ms. */
#define OBSTACLE_PING_INTERVAL_MS ((ULTRASONIC_PING_INTERVAL_US + 999u) / 1000u)

/* Servo wait for a move of deg degrees, as computed by move_sensor(). */
#define OBSTACLE_SETTLE_MS(deg)                                                \
    (((((deg)*OBSTACLE_SERVO_TRAVEL_MS_PER_60_DEG) + 59u) / 60u) +             \
     OBSTACLE_SERVO_SETTLE_MARGIN_MS)

/*
 * Worst case for one side position: every allowed trigger used (pings plus
 * extra attempts), each spaced by the ping interval plus one polling tick,
 * then the last transaction and one more tick: 5 * 70 + 25 + 10 = 385 ms.
 */
#define OBSTACLE_SIDE_POSITION_WORST_MS                                        \
    (((OBSTACLE_PINGS_PER_ANGLE + OBSTACLE_EXTRA_ATTEMPTS_PER_ANGLE) *         \
      (OBSTACLE_PING_INTERVAL_MS + OBSTACLE_TICK_MS)) +                        \
     OBSTACLE_TRANSACTION_MS + OBSTACLE_TICK_MS)

/*
 * Worst case for one fine angle: a one-step move, every allowed trigger,
 * then the last transaction and one tick: 170 + 3 * 70 + 25 + 10 = 415 ms.
 */
#define OBSTACLE_FINE_POSITION_WORST_MS                                        \
    (OBSTACLE_SETTLE_MS(OBSTACLE_SWEEP_STEP_DEG) +                             \
     ((OBSTACLE_FINE_PINGS_PER_ANGLE + OBSTACLE_EXTRA_ATTEMPTS_PER_ANGLE) *    \
      (OBSTACLE_PING_INTERVAL_MS + OBSTACLE_TICK_MS)) +                        \
     OBSTACLE_TRANSACTION_MS + OBSTACLE_TICK_MS)

/*
 * Worst case for both fine walks: every index between an end and the
 * centre (3 per side), plus the longest cross move, from 130 degrees to the
 * first left index: 6 * 415 + 290 = 2780 ms today.
 */
#define OBSTACLE_FINE_SCAN_WORST_MS                                            \
    ((2u * (OBSTACLE_CENTRE_INDEX - 1u) * OBSTACLE_FINE_POSITION_WORST_MS) +   \
     OBSTACLE_SETTLE_MS(OBSTACLE_SWEEP_LAST_DEG - OBSTACLE_SWEEP_FIRST_DEG -   \
                        OBSTACLE_SWEEP_STEP_DEG))

/*
 * Worst case for a side scan: centre-to-left move, left position,
 * left-to-right move, right position, then both fine walks. The return to
 * centre happens after the result is published.
 * Today: 230 + 310 + 2 * 385 + 2780 = 4090 ms.
 */
#define OBSTACLE_SIDE_SCAN_WORST_MS                                            \
    (OBSTACLE_SETTLE_MS(OBSTACLE_CENTRE_DEG - OBSTACLE_SWEEP_FIRST_DEG) +      \
     OBSTACLE_SETTLE_MS(OBSTACLE_SWEEP_LAST_DEG - OBSTACLE_SWEEP_FIRST_DEG) +  \
     (2u * OBSTACLE_SIDE_POSITION_WORST_MS) + OBSTACLE_FINE_SCAN_WORST_MS)

/*
 * Worst case for a corridor sweep (bypass verification): the move from
 * centre to 50 degrees, then every grid position as a side position, with
 * a one-step move before each after the first.
 * Today: 230 + 8 * 170 + 9 * 385 = 5055 ms.
 */
#define OBSTACLE_CORRIDOR_WORST_MS                                             \
    (OBSTACLE_SETTLE_MS(OBSTACLE_CENTRE_DEG - OBSTACLE_SWEEP_FIRST_DEG) +      \
     ((OBSTACLE_SWEEP_POINTS - 1u) *                                           \
      OBSTACLE_SETTLE_MS(OBSTACLE_SWEEP_STEP_DEG)) +                           \
     (OBSTACLE_SWEEP_POINTS * OBSTACLE_SIDE_POSITION_WORST_MS))

/*
 * Watchdog limits. The stop acknowledgement timeout belongs to the motion
 * handshake (integration). The side-scan timeout is twice the worst case,
 * 8180 ms today. It is a fail-safe bound, not a performance target.
 */
#define OBSTACLE_STOP_ACK_TIMEOUT_MS 500u
#define OBSTACLE_SCAN_TIMEOUT_MS (2u * OBSTACLE_SIDE_SCAN_WORST_MS)
#define OBSTACLE_CORRIDOR_TIMEOUT_MS (2u * OBSTACLE_CORRIDOR_WORST_MS)

/*
 * Bypass (issue #86): stop, drive a box around the obstacle and rejoin the
 * line, through tMotion (IF-06). The car dimensions were measured with a
 * ruler on 2026-11-04 (whole mm); enabling the bypass with any of them 0 is
 * a build error. With the bypass off, obstacle never sets INHIBIT or sends
 * motion commands.
 */
#define OBSTACLE_AVOID_ENABLED 1
/* The car's own body shows in the sensor's view at about 5 cm, at servo
 * commands 60-70 (before trim). Side readings nearer than this distance,
 * at a servo command at or below SELF_MAX_DEG or at or above SELF_MIN_DEG,
 * count as no echo; every other reading is used as measured. Centre
 * readings, and so CRITICAL, are not affected. Refit both angles with
 * calibration mode 5 (TODO(calibrate): check the 50-130 sweep against the
 * car); 181 turns the upper range off. */
#define OBSTACLE_SIDE_SELF_DISTANCE_MM 60u
#define OBSTACLE_SIDE_SELF_MAX_DEG 70
#define OBSTACLE_SIDE_SELF_MIN_DEG 181
#define OBSTACLE_SIDE_SELF_ECHO_US                                             \
    OBSTACLE_MM_TO_ECHO_US(OBSTACLE_SIDE_SELF_DISTANCE_MM)
/* Reverse this far when CRITICAL holds a forward bypass move, at most
 * OBSTACLE_AVOID_MAX_BACKOFFS times per bypass, after the hold settles. */
#define OBSTACLE_AVOID_BACKOFF_MM 50u
/* A bypass that starts nearer than this (pivot to obstacle face) reverses
 * to it first, so the first turn does not swing into the obstacle. */
#define OBSTACLE_AVOID_MIN_ROOM_MM 200u
#define OBSTACLE_AVOID_MAX_BACKOFFS 2u
#define OBSTACLE_AVOID_BACKOFF_DELAY_MS 300u
/*
 * W, as twice the wider half: 12.7 cm by ruler, and the left side sticks out
 * 2 cm more than the right (user, 2026-11-06). The bypass treats the car as
 * symmetrical, so both sides get the left side's clearance.
 */
#define OBSTACLE_CAR_WIDTH_MM 167u
#define OBSTACLE_CAR_AXLE_TO_PIVOT_MM 60u /* Axle midpoint to servo pivot. */
#define OBSTACLE_CAR_REAR_MM 162u         /* Axle midpoint to rear bumper. */
#define OBSTACLE_AVOID_LINE_OVERSHOOT_MM 130u /* IR row to axle, 13 cm. */
/*
 * Coming back, black under the IR row counts as the line only once the row
 * is planned to be this close to it. On 2026-11-07 both bypasses stopped for
 * black with the row planned 140 to 200 mm short of the line, probably a
 * cross tape. The pass can drift toward the line, 70 mm in one of those runs,
 * so this must stay above that or the row crosses the line unseen.
 */
#define OBSTACLE_AVOID_LINE_GATE_MM 100u
#define OBSTACLE_AVOID_MARGIN_MM 60u
#define OBSTACLE_AVOID_DEPTH_MM 200u /* Largest test obstacle's depth. */
#define OBSTACLE_AVOID_SIDESTEP_MIN_MM 100u
#define OBSTACLE_AVOID_SIDESTEP_MAX_MM 400u
/* An obstacle on the line reaches at least this far out on the side the car
 * passes, whatever the sweep says: half the widest test obstacle, 230 mm. On
 * 2026-11-08 two sidesteps planned from an edge read 0 and 30 mm off the line
 * left the car's side 60 and 89 mm off it, and it hit a centred obstacle. */
#define OBSTACLE_AVOID_EDGE_MIN_MM 115u
#define OBSTACLE_AVOID_LATERAL_MAX_MM 500u
#define OBSTACLE_AVOID_PASS_MAX_MM 1500u
#define OBSTACLE_AVOID_RETURN_EXTRA_MM 150u
#define OBSTACLE_AVOID_MAX_SIDESTEPS 3u /* First plus two extra. */
#define OBSTACLE_AVOID_RESUME_MIN_MM 10u
#define OBSTACLE_AVOID_RESUME_MIN_DEG 3u
/* Stopped more than RESUME_MIN_DEG off the line's heading, the car turns back
 * onto it and measures from there. The heading is the car's, averaged over the
 * last 3 steps of travel and the moment it was stopped, as a barcode's creep
 * does. Stopped this long first, so the brake has finished. A car further off
 * than the maximum, or that turned that much over those steps, is in a bend or
 * a pivot and has no line's heading to go by; 0 never straightens. Off for now:
 * on 2026-11-08 the average lagged a correction and turned the car away from
 * the obstacle's face, whose nearest echo was 25 to 30 degrees off centre. */
#define OBSTACLE_AVOID_STRAIGHTEN_SETTLE_MS 250u
#define OBSTACLE_AVOID_STRAIGHTEN_STEP_MM 32u
#define OBSTACLE_AVOID_STRAIGHTEN_MAX_DEG 0u
/* 0: one sweep at the stop, then drive the whole path without the corridor
 * sweep or forward re-checks; only CRITICAL holds the car on the way. 1:
 * re-check before each move and verify the corridor (slower). */
#define OBSTACLE_AVOID_RECHECK 0
/* Shallowest turn toward or away from the gap; steeper when the obstacle
 * leaves less room in front. 90 gives the box path. */
#define OBSTACLE_AVOID_ANGLE_MIN_DEG 30u

/*
 * Bypass time limits. A rearm may start a full side scan, and a corridor
 * sweep has its own watchdog, so those limits sit above the scanner's. A
 * blocked bypass may re-sweep the corridor, so its wait exceeds one sweep.
 */
#define OBSTACLE_AVOID_SEND_TIMEOUT_MS 200u

/*
 * Temporary: the "reverse" command backs the stopped car up this far each
 * time, to bring it back between test passes. The limit is a backstop: the
 * move takes under 1 s at MOTION_MOVE_SPEED_MM_S.
 */
#define OBSTACLE_REMOTE_REVERSE_MM 200u
#define OBSTACLE_REMOTE_REVERSE_LIMIT_MS 3000u

#define OBSTACLE_AVOID_PREPARE_TIMEOUT_MS                                      \
    (OBSTACLE_SCAN_TIMEOUT_MS +                                                \
     OBSTACLE_SETTLE_MS(OBSTACLE_SWEEP_LAST_DEG - OBSTACLE_SWEEP_FIRST_DEG))
#define OBSTACLE_AVOID_VERIFY_TIMEOUT_MS (OBSTACLE_CORRIDOR_TIMEOUT_MS + 1000u)
#define OBSTACLE_AVOID_BLOCK_WAIT_MS 30000u
/* Without re-checks a held bypass never faults: it re-sweeps this often
 * until a way round, or a clear path, appears. */
#define OBSTACLE_AVOID_RESWEEP_MS 3000u
#define OBSTACLE_AVOID_RETRY_DELAY_MS 1000u

/*
 * Calibration uses the scan task instead of normal obstacle scanning.
 * Keep OFF in committed configuration; select 1..5 only for bench runs.
 */
#define OBSTACLE_CAL_MODE_OFF 0u
#define OBSTACLE_CAL_MODE_RANGING 1u    /* Fixed 90 degree ping bursts. */
#define OBSTACLE_CAL_MODE_TRIM_SWEEP 2u /* 80..100 degrees, one degree steps. */
#define OBSTACLE_CAL_MODE_SETTLE 3u /* Settling trials in either direction. */
#define OBSTACLE_CAL_MODE_ANGLES 4u /* Holds, including 60 to 120 moves. */
#define OBSTACLE_CAL_MODE_WIDE 5u   /* The sweep, five degree steps. */

#define OBSTACLE_CALIBRATION_MODE OBSTACLE_CAL_MODE_OFF
#define OBSTACLE_CAL_PINGS 20u

/*
 * Mode 3 destination, and the size of each trial move towards it: 60 moves
 * from the opposite end, 5 checks single fine-sweep steps.
 */
#define OBSTACLE_CAL_SETTLE_TARGET_DEG 60
#define OBSTACLE_CAL_SETTLE_MOVE_DEG 60

/* Signed command correction: physical centre command minus 90 degrees. */
#define OBSTACLE_SERVO_TRIM_DEG 0

/*
 * Servo direction. Scan angles below 90 are left of the heading (+x). Set
 * 1 if the servo is mounted so that a command below 90 faces right: check
 * with calibration mode 5 and an object on the car's left. 0 keeps the
 * commands equal to the scan angles. This car needs 0. At 1 (2026-11-08 to
 * 11-10) an obstacle 30% left and 70% right of the line read with its edges
 * swapped, about 6 to 9 cm on the right and over 13 cm on the left, and the
 * car went round its wider side every time (OBS-U80).
 */
#define OBSTACLE_SERVO_MIRRORED 0
/* Servo command, before trim, that points the sensor at a scan angle. */
#define OBSTACLE_SERVO_PHYSICAL_DEG(angle)                                     \
    (OBSTACLE_SERVO_MIRRORED ? (180 - (int)(angle)) : (int)(angle))
#define OBSTACLE_SERVO_COMMAND_DEG(angle)                                      \
    (OBSTACLE_SERVO_PHYSICAL_DEG(angle) + OBSTACLE_SERVO_TRIM_DEG)

/* Compile-time consistency checks. */

#if (OBSTACLE_SOUND_MM_PER_10K_US <= 0LL) ||                                   \
    (OBSTACLE_SOUND_MM_PER_10K_US > 4294967295LL)
#error "Echo scale must be positive and fit 32 bits"
#endif

#if (OBSTACLE_ECHO_OFFSET_MM < -400000LL) ||                                   \
    (OBSTACLE_ECHO_OFFSET_MM > 400000LL)
#error "Echo offset must lie within -400000..400000 mm"
#endif

#if ((OBSTACLE_CRITICAL_DISTANCE_MM + 0LL) < 0LL) ||                           \
    ((OBSTACLE_CRITICAL_RELEASE_DISTANCE_MM + 0LL) < 0LL) ||                   \
    ((OBSTACLE_DETECT_DISTANCE_MM + 0LL) < 0LL) ||                             \
    (OBSTACLE_CRITICAL_DISTANCE_MM > 400000LL) ||                              \
    (OBSTACLE_CRITICAL_RELEASE_DISTANCE_MM > 400000LL) ||                      \
    (OBSTACLE_DETECT_DISTANCE_MM > 400000LL)
#error "Threshold distances must lie within 0..400000 mm"
#endif

/*
 * In #if, unsigned distances promote even LL operands to uintmax_t.
 * Compare only nonnegative offsets to avoid interpreting negatives as huge.
 */
#if OBSTACLE_ECHO_OFFSET_MM >= 0
#if (OBSTACLE_CRITICAL_DISTANCE_MM <= OBSTACLE_ECHO_OFFSET_MM) ||              \
    (OBSTACLE_CRITICAL_RELEASE_DISTANCE_MM <= OBSTACLE_ECHO_OFFSET_MM) ||      \
    (OBSTACLE_DETECT_DISTANCE_MM <= OBSTACLE_ECHO_OFFSET_MM)
#error "Thresholds must lie above the echo offset"
#endif
#endif

#if (OBSTACLE_CAL_SETTLE_TARGET_DEG != 60) &&                                  \
    (OBSTACLE_CAL_SETTLE_TARGET_DEG != 120)
#error "Calibration settle destination must be 60 or 120 degrees"
#endif

#if (OBSTACLE_CAL_SETTLE_MOVE_DEG != 60) && (OBSTACLE_CAL_SETTLE_MOVE_DEG != 5)
#error "Calibration settle move must be 60 or 5 degrees"
#endif

#if OBSTACLE_FINE_PINGS_PER_ANGLE != 1u
#error "The fine walk reads exactly one ping per angle"
#endif

#if (OBSTACLE_CENTRE_CONFIRM_PINGS != 3u) || (OBSTACLE_CENTRE_NEAR_VOTES != 2u)
#error "Centre confirmation requires two of three usable pings"
#endif

#if OBSTACLE_FORWARD_PERIOD_MS < ((ULTRASONIC_PING_INTERVAL_US + 999u) / 1000u)
#error "Forward period cannot be shorter than the driver ping interval"
#endif

#if OBSTACLE_SWEEP_STEP_DEG == 0u
#error "Sweep step must be nonzero"
#else

#if OBSTACLE_SWEEP_LAST_DEG <= OBSTACLE_SWEEP_FIRST_DEG
#error "Sweep limits must be increasing"
#endif

#if ((OBSTACLE_SWEEP_LAST_DEG - OBSTACLE_SWEEP_FIRST_DEG) %                    \
     OBSTACLE_SWEEP_STEP_DEG) != 0u
#error "Sweep interval must divide exactly into the sweep range"
#endif

#if (OBSTACLE_CENTRE_DEG < OBSTACLE_SWEEP_FIRST_DEG) ||                        \
    (OBSTACLE_CENTRE_DEG > OBSTACLE_SWEEP_LAST_DEG)
#error "Centre must lie within the sweep"
#endif

#if ((OBSTACLE_CENTRE_DEG - OBSTACLE_SWEEP_FIRST_DEG) %                        \
     OBSTACLE_SWEEP_STEP_DEG) != 0u
#error "Centre must be one of the sampled angles"
#endif

#if OBSTACLE_SWEEP_POINTS > 15u
#error "Four-bit edge index reserves 15 for unavailable"
#endif

#endif /* OBSTACLE_SWEEP_STEP_DEG */

#if (ULTRASONIC_ECHO_BITS < 1u) || (ULTRASONIC_ECHO_BITS > 15u)
#error "Echo field must fit the agreed 15-bit maximum"
#endif

#if ULTRASONIC_PULSE_TIMEOUT_US > ULTRASONIC_ECHO_MAX_US
#error "Pulse timeout exceeds the stored echo range"
#endif

#if OBSTACLE_CRITICAL_DISTANCE_MM >= OBSTACLE_DETECT_DISTANCE_MM
#error "Critical distance must be below the detection distance"
#endif

#if !((OBSTACLE_CRITICAL_ECHO_US < OBSTACLE_CRITICAL_RELEASE_ECHO_US) &&       \
      (OBSTACLE_CRITICAL_RELEASE_ECHO_US < OBSTACLE_DETECT_ECHO_US))
#error "Thresholds must satisfy critical < critical release < detection"
#endif

#if (OBSTACLE_DETECT_ECHO_US >= ULTRASONIC_PULSE_TIMEOUT_US) ||                \
    (OBSTACLE_DETECT_ECHO_US > ULTRASONIC_ECHO_MAX_US)
#error "Detection threshold must lie inside the measurable echo range"
#endif

#if OBSTACLE_FORWARD_MAX_AGE_MS <=                                             \
    (OBSTACLE_FORWARD_PERIOD_MS + OBSTACLE_TRANSACTION_MS + OBSTACLE_TICK_MS)
#error "Freshness limit must exceed the age of a healthy forward reading"
#endif

#if OBSTACLE_SERVO_SETTLE_MARGIN_MS < OBSTACLE_TRANSACTION_MS
#error "Settle margin must outlast an in-flight measurement (drain rule)"
#endif

#if (OBSTACLE_WATCH_LEFT_DEG < OBSTACLE_SWEEP_FIRST_DEG) ||                    \
    (OBSTACLE_WATCH_LEFT_DEG >= OBSTACLE_CENTRE_DEG) ||                        \
    (OBSTACLE_WATCH_RIGHT_DEG != (180u - OBSTACLE_WATCH_LEFT_DEG)) ||          \
    (OBSTACLE_WATCH_RIGHT_DEG > OBSTACLE_SWEEP_LAST_DEG)
#error "Watch angles must mirror each other inside the sweep, off centre"
#endif

#if (OBSTACLE_SERVO_MIRRORED != 0) && (OBSTACLE_SERVO_MIRRORED != 1)
#error "OBSTACLE_SERVO_MIRRORED must be 0 or 1"
#endif

#if OBSTACLE_TICK_MS != CNF_TIMER_PERIOD
#error "Tick must match CNF_TIMER_PERIOD in config/config.h"
#endif

#if (OBSTACLE_CALIBRATION_MODE < OBSTACLE_CAL_MODE_OFF) ||                     \
    (OBSTACLE_CALIBRATION_MODE > OBSTACLE_CAL_MODE_WIDE)
#error "OBSTACLE_CALIBRATION_MODE must be one of the OBSTACLE_CAL_MODE_ values"
#endif

#if OBSTACLE_CALIBRATION_MODE != OBSTACLE_CAL_MODE_OFF
#warning "Calibration build: obstacle scanning disabled"
#endif

#if (OBSTACLE_CAL_PINGS == 0u) || (OBSTACLE_CAL_PINGS > 255u)
#error "Calibration ping count must be 1..255"
#endif

#if (OBSTACLE_SERVO_TRIM_DEG < -10) || (OBSTACLE_SERVO_TRIM_DEG > 10)
#error "Servo trim beyond 10 degrees: re-seat the horn instead"
#endif

#if OBSTACLE_AVOID_ENABLED
#if (OBSTACLE_CAR_WIDTH_MM == 0u) || (OBSTACLE_CAR_AXLE_TO_PIVOT_MM == 0u) ||  \
    (OBSTACLE_CAR_REAR_MM == 0u)
#error "Measure the car (OBS-U31, ruler) before enabling the bypass"
#endif
#endif
#if !((OBSTACLE_AVOID_SIDESTEP_MIN_MM <= OBSTACLE_AVOID_SIDESTEP_MAX_MM) &&    \
      (OBSTACLE_AVOID_SIDESTEP_MAX_MM <= OBSTACLE_AVOID_LATERAL_MAX_MM) &&     \
      (OBSTACLE_AVOID_RESUME_MIN_MM < OBSTACLE_AVOID_SIDESTEP_MIN_MM))
#error "Bypass sidesteps must satisfy resume < min <= max <= lateral max"
#endif
#if (OBSTACLE_AVOID_ANGLE_MIN_DEG < 5u) || (OBSTACLE_AVOID_ANGLE_MIN_DEG > 90u)
#error "Bypass turn angle must be 5..90 degrees"
#endif
#if (OBSTACLE_AVOID_MAX_SIDESTEPS < 1u) || (OBSTACLE_AVOID_MAX_SIDESTEPS > 255u)
#error "Bypass sidestep count must be 1..255"
#endif
#if (OBSTACLE_AVOID_LATERAL_MAX_MM + OBSTACLE_AVOID_RETURN_EXTRA_MM >          \
     65535u) ||                                                                \
    (OBSTACLE_AVOID_PASS_MAX_MM > 65535u) ||                                   \
    (OBSTACLE_CAR_WIDTH_MM > 65535u) || (OBSTACLE_AVOID_RESUME_MIN_DEG > 255u)
#error "Bypass distances must fit 16 bits"
#endif
#if (OBSTACLE_AVOID_EDGE_MIN_MM + (OBSTACLE_CAR_WIDTH_MM / 2u) +               \
     OBSTACLE_AVOID_MARGIN_MM) > OBSTACLE_AVOID_SIDESTEP_MAX_MM
#error "The largest sidestep must clear OBSTACLE_AVOID_EDGE_MIN_MM"
#endif
#if (OBSTACLE_AVOID_STRAIGHTEN_MAX_DEG > 255u) ||                              \
    (OBSTACLE_AVOID_STRAIGHTEN_STEP_MM > 65535u)
#error "Straightening limits must fit their fields"
#endif
#if OBSTACLE_AVOID_BLOCK_WAIT_MS <= OBSTACLE_CORRIDOR_WORST_MS
#error "A blocked bypass must be able to wait through one corridor sweep"
#endif

/* Public function declarations. */

#endif /* OBSTACLE_CONFIG_H */
