SITProjects/INF2004/app_program/terrain/terrain_config.h

/**
 * @file terrain_config.h
 * @brief Wiring and tunables for the terrain (IMU) module.
 *
 * Every value can be overridden before this header is included, for
 * example with a compiler -D flag, so the team can change tunables
 * without editing this file.
 *
 * The I2C wiring is not set here: the kernel's I2C driver owns the bus.
 * The GY-511 is on the Robo Pico's Grove port 3: I2C0 with SDA on GP4 and
 * SCL on GP5, at 400 kHz. Pins and the transfer timeout are in
 * device/i2c/sysdepend/rp2040/i2c_cnf_sysdep.h (DEVCNF_I2C0_*), and
 * config/config_device.h switches the driver on (DEVCNF_USE_IIC). Record
 * any change of pins in TEAM.md first.
 *
 * Copyright (c) 2026 10x Slackers
 * SPDX-License-Identifier: MIT
 */

#ifndef TERRAIN_CONFIG_H
#define TERRAIN_CONFIG_H

/* Public includes. */
#include "drv_imu.h"

/* Public types, constants, and macros. */

/* 7-bit I2C addresses of the LSM303DLHC's two sensors. */
#ifndef TERRAIN_ACCEL_ADDR
#define TERRAIN_ACCEL_ADDR 0x19u
#endif

#ifndef TERRAIN_MAG_ADDR
#define TERRAIN_MAG_ADDR 0x1Eu
#endif

/*
 * Magnetometer (compass) rate and range, as imu_mag_odr_t and
 * imu_mag_gain_t values from drv_imu.h. 75 Hz gives most 10 ms updates a
 * fresh sample. +/-1.3 gauss covers the Earth's field (0.25 to 0.65
 * gauss) with room for the car's own; raise it if readings overflow.
 */
#ifndef TERRAIN_MAG_ODR
#define TERRAIN_MAG_ODR IMU_MAG_ODR_75HZ
#endif
#ifndef TERRAIN_MAG_GAIN
#define TERRAIN_MAG_GAIN IMU_MAG_GAIN_1_3_GAUSS
#endif

/*
 * Hard-iron offset, in car axes and magnetometer counts: the field of the
 * car's own magnets (motors, speaker), which turns with the car. Measure
 * it with the calibration spin (TER-U28): the "centre" values printed
 * after two slow full turns. Measure it again if anything magnetic on
 * the car moves. Current values: TER-U28, 2026-11-06, motors off (spans
 * 956 and 904 counts, so the Earth's field is about 0.42 gauss here).
 * With the motors running the field the compass sees changes by up to
 * half of that (TER-U31), so the heading is not yet good for steering.
 */
#ifndef TERRAIN_MAG_OFFSET_X
#define TERRAIN_MAG_OFFSET_X (-347)
#endif
#ifndef TERRAIN_MAG_OFFSET_Y
#define TERRAIN_MAG_OFFSET_Y (-96)
#endif

/*
 * Print the compass (raw X, Y, Z, heading and the X/Y centre and span
 * seen so far) this often, in ms; 0 never. On in the IR_CALIBRATION=1
 * image, where the motors stay off, for the calibration spin.
 */
#ifndef TERRAIN_COMPASS_PRINT_MS
#if IR_CALIBRATION_ONLY
#define TERRAIN_COMPASS_PRINT_MS 250
#else
#define TERRAIN_COMPASS_PRINT_MS 0
#endif
#endif

/*
 * Accelerometer data rate, as an imu_accel_odr_t value from drv_imu.h.
 * Matches the 100 Hz update rate.
 */
#ifndef TERRAIN_ACCEL_ODR
#define TERRAIN_ACCEL_ODR IMU_ACCEL_ODR_100HZ
#endif

/*
 * Accelerometer range, as an imu_accel_range_t value from drv_imu.h.
 * +/-8 g so a lift or a knock does not clip; costs resolution (4 mg per
 * count).
 */
#ifndef TERRAIN_ACCEL_RANGE
#define TERRAIN_ACCEL_RANGE IMU_ACCEL_RANGE_8G
#endif

/*
 * 1: collect samples in the chip's 32-sample buffer, so none are lost
 *    when terrain_monitor_update() runs late.
 * 0: read only the newest sample each update (simpler; for debugging).
 */
#ifndef TERRAIN_ACCEL_USE_FIFO
#define TERRAIN_ACCEL_USE_FIFO 1
#endif

/*
 * Axis mapping: how the board is mounted on the car.
 *
 * Car axes: X = right, Y = forward, Z = up.
 * For each car axis, _FROM picks the board axis it comes from
 * (0 = board X, 1 = board Y, 2 = board Z) and _SIGN is 1 or -1.
 * Default: board axes already match the car.
 *
 * Example, board turned 90 degrees so its X points forward and its Y
 * points left: CAR_X_FROM 1 SIGN -1, CAR_Y_FROM 0 SIGN 1, CAR_Z_FROM 2
 * SIGN 1.
 */
#ifndef TERRAIN_CAR_X_FROM
#define TERRAIN_CAR_X_FROM 0
#endif
#ifndef TERRAIN_CAR_X_SIGN
#define TERRAIN_CAR_X_SIGN 1
#endif
#ifndef TERRAIN_CAR_Y_FROM
#define TERRAIN_CAR_Y_FROM 1
#endif
#ifndef TERRAIN_CAR_Y_SIGN
#define TERRAIN_CAR_Y_SIGN 1
#endif
#ifndef TERRAIN_CAR_Z_FROM
#define TERRAIN_CAR_Z_FROM 2
#endif
#ifndef TERRAIN_CAR_Z_SIGN
#define TERRAIN_CAR_Z_SIGN 1
#endif

#if (TERRAIN_CAR_X_FROM == TERRAIN_CAR_Y_FROM) ||                              \
    (TERRAIN_CAR_X_FROM == TERRAIN_CAR_Z_FROM) ||                              \
    (TERRAIN_CAR_Y_FROM == TERRAIN_CAR_Z_FROM)
#error "TERRAIN_CAR_*_FROM must use each board axis exactly once"
#endif
#if (TERRAIN_CAR_X_FROM < 0) || (TERRAIN_CAR_X_FROM > 2) ||                    \
    (TERRAIN_CAR_Y_FROM < 0) || (TERRAIN_CAR_Y_FROM > 2) ||                    \
    (TERRAIN_CAR_Z_FROM < 0) || (TERRAIN_CAR_Z_FROM > 2)
#error "TERRAIN_CAR_*_FROM must be 0, 1 or 2"
#endif
#if ((TERRAIN_CAR_X_SIGN != 1) && (TERRAIN_CAR_X_SIGN != -1)) ||               \
    ((TERRAIN_CAR_Y_SIGN != 1) && (TERRAIN_CAR_Y_SIGN != -1)) ||               \
    ((TERRAIN_CAR_Z_SIGN != 1) && (TERRAIN_CAR_Z_SIGN != -1))
#error "TERRAIN_CAR_*_SIGN must be 1 or -1"
#endif

/*
 * Accelerometer gain per BOARD axis, from the six-side test: lay the
 * board with each axis pointing up, then down, and use
 * gain = 2 x 9.80665 / (reading up - reading down).
 * Gains belong to the chip, not the mounting; redo the test only if the
 * GY-511 board is replaced.
 */
#ifndef TERRAIN_GAIN_BOARD_X
#define TERRAIN_GAIN_BOARD_X 0.981f
#endif
#ifndef TERRAIN_GAIN_BOARD_Y
#define TERRAIN_GAIN_BOARD_Y 0.977f
#endif
#ifndef TERRAIN_GAIN_BOARD_Z
#define TERRAIN_GAIN_BOARD_Z 0.995f
#endif

/*
 * Level reference: the average reading, in car axes and m/s^2 with gains
 * applied, of the car standing still on a floor checked to be flat.
 * Boot calibration compares against it to decide whether the car is
 * level. Record it again whenever the sensor is remounted.
 * Current values: the mean of eight boots with the sensor mounted, on the
 * floor (2026-11-09, all within 1.6 degrees of the mean), from the
 * `terrain: calibration` line. The car had come to rest about 5 degrees
 * further front to back than on 2026-11-07, and most boots read NOT_LEVEL.
 */
#ifndef TERRAIN_LEVEL_REF_X
#define TERRAIN_LEVEL_REF_X (-0.463f)
#endif
#ifndef TERRAIN_LEVEL_REF_Y
#define TERRAIN_LEVEL_REF_Y (-1.765f)
#endif
#ifndef TERRAIN_LEVEL_REF_Z
#define TERRAIN_LEVEL_REF_Z (8.373f)
#endif

/* Samples in one calibration attempt: 200 is 2 s at 100 Hz. */
#ifndef TERRAIN_CALIB_SAMPLES
#define TERRAIN_CALIB_SAMPLES 200u
#endif

#if TERRAIN_CALIB_SAMPLES < 1
#error "TERRAIN_CALIB_SAMPLES must be at least 1"
#endif

/*
 * Samples skipped at the start of every calibration (power-up and each
 * recalibration), so a hand leaving the car or the car rocking on its
 * wheels is not averaged in: 50 is 0.5 s at 100 Hz. Not repeated
 * between the attempts of one calibration.
 */
#ifndef TERRAIN_CALIB_SETTLE_SAMPLES
#define TERRAIN_CALIB_SETTLE_SAMPLES 50u
#endif

/*
 * Stillness: largest allowed (max - min) on any axis during an attempt,
 * in m/s^2. Readings move in steps of about 0.16 m/s^2, so this allows
 * about four steps of noise.
 */
#ifndef TERRAIN_CALIB_MAX_SPREAD_MPS2
#define TERRAIN_CALIB_MAX_SPREAD_MPS2 0.6f
#endif

/*
 * Stillness: largest allowed difference between the size of the average
 * reading and the size of the level reference, in m/s^2. A bigger
 * difference means the car was being pushed or lifted.
 */
#ifndef TERRAIN_CALIB_MAX_GRAVITY_ERR_MPS2
#define TERRAIN_CALIB_MAX_GRAVITY_ERR_MPS2 0.5f
#endif

/*
 * Largest allowed angle, in degrees, between the measured gravity
 * direction and the level reference. Above it the car is not on level
 * ground and calibration stops with NOT_LEVEL.
 * Calibration zeroes on the car as it stands, so this is what stops a car
 * powered up on a slope from reading tilted for the whole run. Boots on the
 * floor agree within 1 degree; 2 degrees left little room for a floor that
 * is not quite flat, and NOT_LEVEL turns tilt and humps off.
 */
#ifndef TERRAIN_LEVEL_MAX_DEG
#define TERRAIN_LEVEL_MAX_DEG 5.0f
#endif

/*
 * Failed terrain_monitor_update() calls in a row before the I2C bus and sensor
 * are set up again. 10 is 100 ms at the 10 ms update rate.
 */
#ifndef TERRAIN_FAULT_RETRY_UPDATES
#define TERRAIN_FAULT_RETRY_UPDATES 10u
#endif

#if TERRAIN_FAULT_RETRY_UPDATES < 1
#error "TERRAIN_FAULT_RETRY_UPDATES must be at least 1"
#endif

/*
 * Time between accelerometer samples, in seconds. Must match
 * TERRAIN_ACCEL_ODR: 0.01 s at 100 Hz. Filters are set in seconds and
 * use this, so they keep their timing if the rate changes.
 */
#ifndef TERRAIN_SAMPLE_PERIOD_S
#define TERRAIN_SAMPLE_PERIOD_S 0.01f
#endif

/*
 * Tilt smoothing time constant, in seconds. After a change of angle,
 * pitch and roll cover about two thirds of it in this time and 95 % in
 * three times it. Larger is smoother but slower.
 */
#ifndef TERRAIN_TILT_TAU_S
#define TERRAIN_TILT_TAU_S 0.15f
#endif

/*
 * Hump state machine (terrain_detect.h), on the lean (size of the
 * smoothed roll) while calibrated. The course's humps are ramps under one
 * drive wheel, so the car leans sideways. A wheel lifted h mm leans the
 * car by asin(h / TERRAIN_TRACK_WIDTH_MM): on a 110.6 mm track, 1 mm is
 * about 0.52 degrees, and an 11 mm ramp about 5.7 degrees.
 *
 * Climb: lean above TERRAIN_HUMP_UP_DEG for TERRAIN_HUMP_ENTER_SAMPLES
 * samples in a row (5 = 50 ms, so a single jolt does not count). 2.1
 * degrees is about 4 mm: above the lean that line-following turns fake
 * (about 1 degree), well below an 11 mm ramp.
 */
#ifndef TERRAIN_HUMP_UP_DEG
#define TERRAIN_HUMP_UP_DEG 2.1f
#endif

/*
 * Descent: lean at least this far below the hump's peak for
 * TERRAIN_HUMP_ENTER_SAMPLES samples, degrees. 1.1 degrees is about
 * 2 mm, so wobbles on the top of a ramp do not count.
 */
#ifndef TERRAIN_HUMP_DROP_DEG
#define TERRAIN_HUMP_DROP_DEG 1.1f
#endif

/* Flat again: lean below this for TERRAIN_HUMP_LEVEL_SAMPLES (about
 * 2 mm). */
#ifndef TERRAIN_HUMP_LEVEL_DEG
#define TERRAIN_HUMP_LEVEL_DEG 1.1f
#endif

/*
 * Humps are looked for only while following the line at this speed or more,
 * in mm/s. 15 of 17 false humps on 2026-11-07 came from moves at 300 mm/s,
 * pivots and the car being handled, and one more from pulling away. A slower
 * car only pauses the search: braking for a hump dips below this, and ending
 * the hump there cut every pass into short leans that never counted.
 */
#ifndef TERRAIN_HUMP_MIN_SPEED_MM_S
#define TERRAIN_HUMP_MIN_SPEED_MM_S 20
#endif

/*
 * A hump shorter than this, in mm of travel, is not counted. The course's
 * 192 mm hump took 188 mm from climb to level on 2026-11-07, and at least 135
 * in the model; the lean of steering took 34 to 122 mm. Travel, as time lets
 * in leans of a slow car.
 */
#ifndef TERRAIN_HUMP_MIN_MM
#define TERRAIN_HUMP_MIN_MM 130
#endif

/*
 * A car at this speed or less as a hump ends slowed for it, in mm/s, and the
 * hump needs only TERRAIN_HUMP_SLOW_MIN_MM of travel. Slow, the lean ends with
 * little smoothing lag: the 192 mm hump took 66 to 116 mm on 15 logged slowed
 * passes to 2026-11-09, against 150 or more at speed. A false lean is braked
 * at once, so it covers far less: 55 mm or under on the same logs.
 */
#ifndef TERRAIN_HUMP_SLOW_MM_S
#define TERRAIN_HUMP_SLOW_MM_S 60
#endif

#ifndef TERRAIN_HUMP_SLOW_MIN_MM
#define TERRAIN_HUMP_SLOW_MIN_MM 60
#endif

/* Samples in a row to start a climb or a descent: 5 = 50 ms. */
#ifndef TERRAIN_HUMP_ENTER_SAMPLES
#define TERRAIN_HUMP_ENTER_SAMPLES 5u
#endif

/* Samples in a row with no new peak to reach the top: 10 = 100 ms. */
#ifndef TERRAIN_HUMP_TOP_SAMPLES
#define TERRAIN_HUMP_TOP_SAMPLES 10u
#endif

/* Flat samples in a row to end a descent: 10 = 100 ms. */
#ifndef TERRAIN_HUMP_LEVEL_SAMPLES
#define TERRAIN_HUMP_LEVEL_SAMPLES 10u
#endif

/* The hump counters are 4 bits wide. */
#if (TERRAIN_HUMP_ENTER_SAMPLES < 1) || (TERRAIN_HUMP_ENTER_SAMPLES > 15)
#error "TERRAIN_HUMP_ENTER_SAMPLES must be 1 to 15"
#endif
#if (TERRAIN_HUMP_LEVEL_SAMPLES < 1) || (TERRAIN_HUMP_LEVEL_SAMPLES > 15)
#error "TERRAIN_HUMP_LEVEL_SAMPLES must be 1 to 15"
#endif
#if (TERRAIN_HUMP_TOP_SAMPLES < 1) || (TERRAIN_HUMP_TOP_SAMPLES > 15)
#error "TERRAIN_HUMP_TOP_SAMPLES must be 1 to 15"
#endif

/*
 * Hump height (terrain_height.h). Track width: centre of one drive wheel
 * to the centre of the other, in mm. The height is track width x
 * sin(lean), so a track width 10 % too wide reads every height 10 % too
 * high. 110.6 mm is motion's MOTION_TRACK_WIDTH_MM (same car), calibrated
 * for turns (MOT-U11/U12); the wheels measure 107.5 mm apart, so heights
 * read about 3 % high.
 */
#ifndef TERRAIN_TRACK_WIDTH_MM
#define TERRAIN_TRACK_WIDTH_MM 110.6f
#endif

/*
 * Roll smoothing for the hump height only, in seconds. Lighter lets more
 * motor vibration through, which reads high: 0.05 read the course's 10 mm hump
 * as 16 mm at 120 mm/s on 2026-11-07. Its ramp is long enough for the tilt's
 * 0.15 s, where the model reads 9 to 10 mm.
 */
#ifndef TERRAIN_HUMP_HEIGHT_TAU_S
#define TERRAIN_HUMP_HEIGHT_TAU_S 0.15f
#endif

/*
 * Lifted and overturned (terrain_detect.h): the motors stop when the car is
 * picked up or turned over; lifting it ends a demonstration run. Both use
 * the mean of the last TERRAIN_DETECT_LIFT_WINDOW samples (100 ms), before
 * the bias, against the level reading taken at calibration.
 *
 * Lifted: the upward acceleration, in hundredths of the level reading,
 * goes above TERRAIN_LIFT_UP_CG. On 2026-11-11 (TER-U34) eight brisk lifts,
 * moving and stopped, peaked at 142 to 163; 43 s of floor driving with
 * starts, stops and bumps never passed 117. A slow, gentle lift (109) is
 * not seen: no limit could catch it without stopping the car while driving.
 */
#ifndef TERRAIN_LIFT_UP_CG
#define TERRAIN_LIFT_UP_CG 130u
#endif

/*
 * Overturned: tilted from level by more than TERRAIN_LIFT_OVER_DEG degrees
 * for TERRAIN_LIFT_OVER_SAMPLES samples in a row (300 ms). On its side the
 * car read 73 to 110 degrees, upside down 147 to 179; floor driving never
 * passed 24.
 */
#ifndef TERRAIN_LIFT_OVER_DEG
#define TERRAIN_LIFT_OVER_DEG 60u
#endif
#ifndef TERRAIN_LIFT_OVER_SAMPLES
#define TERRAIN_LIFT_OVER_SAMPLES 30u
#endif

/* Samples after a lift or overturn before the next: 100 = 1 s, so one lift
 * gives one event. */
#ifndef TERRAIN_LIFT_COOLDOWN_SAMPLES
#define TERRAIN_LIFT_COOLDOWN_SAMPLES 100u
#endif

/* The counters are 8 bits; the limit fits the 12-bit event value. */
#if (TERRAIN_LIFT_UP_CG < 105) || (TERRAIN_LIFT_UP_CG > 400)
#error "TERRAIN_LIFT_UP_CG must be 105 to 400"
#endif
#if (TERRAIN_LIFT_OVER_DEG < 30) || (TERRAIN_LIFT_OVER_DEG > 170)
#error "TERRAIN_LIFT_OVER_DEG must be 30 to 170"
#endif
#if (TERRAIN_LIFT_OVER_SAMPLES < 1) || (TERRAIN_LIFT_OVER_SAMPLES > 255)
#error "TERRAIN_LIFT_OVER_SAMPLES must be 1 to 255"
#endif
#if (TERRAIN_LIFT_COOLDOWN_SAMPLES < 1) || (TERRAIN_LIFT_COOLDOWN_SAMPLES > 255)
#error "TERRAIN_LIFT_COOLDOWN_SAMPLES must be 1 to 255"
#endif

/*
 * Turning state (terrain_detect.h), from the turn rate: how fast the
 * car's body rotates, worked out from motion's two wheel speeds, in
 * degrees per second. Either way round counts the same.
 *
 * TURNING once the turn rate stays above TERRAIN_TURN_ON_DPS for
 * TERRAIN_TURN_ON_SAMPLES samples (10 = 100 ms, so one steering twitch
 * does not count). Turns in place run at 90 deg/s (MOTION_TURN_SPEED_DEG_S)
 * and always count; a gentle line-following curve below 20 deg/s is just
 * following the line, not a turn.
 * STRAIGHT once it stays below TERRAIN_TURN_OFF_DPS for
 * TERRAIN_TURN_OFF_SAMPLES samples (30 = 300 ms). The gap between the two
 * limits stops the state flickering when the rate hovers near one of
 * them. TODO(car day): check the small line-following corrections stay
 * under the on limit (TER-U23).
 */
#ifndef TERRAIN_TURN_ON_DPS
#define TERRAIN_TURN_ON_DPS 20u
#endif

#ifndef TERRAIN_TURN_OFF_DPS
#define TERRAIN_TURN_OFF_DPS 10u
#endif

#ifndef TERRAIN_TURN_ON_SAMPLES
#define TERRAIN_TURN_ON_SAMPLES 10u
#endif

#ifndef TERRAIN_TURN_OFF_SAMPLES
#define TERRAIN_TURN_OFF_SAMPLES 30u
#endif

/* The turn rate field stops at 255 deg/s; the turn counter is 5 bits. */
#if (TERRAIN_TURN_ON_DPS < 1) || (TERRAIN_TURN_ON_DPS > 255)
#error "TERRAIN_TURN_ON_DPS must be 1 to 255"
#endif
#if (TERRAIN_TURN_OFF_DPS < 1) || (TERRAIN_TURN_OFF_DPS >= TERRAIN_TURN_ON_DPS)
#error "TERRAIN_TURN_OFF_DPS must be 1 to below TERRAIN_TURN_ON_DPS"
#endif
#if (TERRAIN_TURN_ON_SAMPLES < 1) || (TERRAIN_TURN_ON_SAMPLES > 31)
#error "TERRAIN_TURN_ON_SAMPLES must be 1 to 31"
#endif
#if (TERRAIN_TURN_OFF_SAMPLES < 1) || (TERRAIN_TURN_OFF_SAMPLES > 31)
#error "TERRAIN_TURN_OFF_SAMPLES must be 1 to 31"
#endif

/*
 * Speed state (terrain_detect.h), from the wheel speed: the average of
 * the sizes of motion's two wheel speeds, in mm/s, so a turn in place
 * (wheels at +84 and -84 mm/s) counts as moving at 84 mm/s.
 *
 * Every TERRAIN_SPEED_WINDOW_SAMPLES samples (10 = 100 ms, the same span
 * motion averages its speeds over) the speed is compared with the
 * previous check. Below TERRAIN_SPEED_STOP_MM_S is stopped (motion's
 * slowest drive is 30 mm/s, over a barcode); a rise or fall of at least
 * TERRAIN_SPEED_CHANGE_MM_S is speeding up or slowing down (15 mm/s in
 * 100 ms is 150 mm/s^2); less is cruising. The state changes once the
 * same answer comes TERRAIN_SPEED_CONFIRM_CHECKS checks in a row
 * (TERRAIN_SPEED_STOP_CHECKS for STATIONARY), so one noisy check does
 * not count. TODO(car day): tune the change limit and the checks
 * (TER-U25).
 */
#ifndef TERRAIN_SPEED_STOP_MM_S
#define TERRAIN_SPEED_STOP_MM_S 20u
#endif

#ifndef TERRAIN_SPEED_CHANGE_MM_S
#define TERRAIN_SPEED_CHANGE_MM_S 15u
#endif

#ifndef TERRAIN_SPEED_WINDOW_SAMPLES
#define TERRAIN_SPEED_WINDOW_SAMPLES 10u
#endif

#ifndef TERRAIN_SPEED_CONFIRM_CHECKS
#define TERRAIN_SPEED_CONFIRM_CHECKS 2u
#endif

#ifndef TERRAIN_SPEED_STOP_CHECKS
#define TERRAIN_SPEED_STOP_CHECKS 3u
#endif

/* The speed field stops at 510 mm/s in 2 mm/s steps; the window count is
 * 4 bits and the confirm count 2 bits. */
#if (TERRAIN_SPEED_STOP_MM_S < 2) || (TERRAIN_SPEED_STOP_MM_S > 500)
#error "TERRAIN_SPEED_STOP_MM_S must be 2 to 500"
#endif
#if (TERRAIN_SPEED_CHANGE_MM_S < 2) || (TERRAIN_SPEED_CHANGE_MM_S > 500)
#error "TERRAIN_SPEED_CHANGE_MM_S must be 2 to 500"
#endif
#if (TERRAIN_SPEED_WINDOW_SAMPLES < 1) || (TERRAIN_SPEED_WINDOW_SAMPLES > 15)
#error "TERRAIN_SPEED_WINDOW_SAMPLES must be 1 to 15"
#endif
#if (TERRAIN_SPEED_CONFIRM_CHECKS < 1) || (TERRAIN_SPEED_CONFIRM_CHECKS > 3)
#error "TERRAIN_SPEED_CONFIRM_CHECKS must be 1 to 3"
#endif
#if (TERRAIN_SPEED_STOP_CHECKS < 1) || (TERRAIN_SPEED_STOP_CHECKS > 3)
#error "TERRAIN_SPEED_STOP_CHECKS must be 1 to 3"
#endif

/*
 * Motion's odometry (TEAM.md IF-05) counts as stale, and its distance as
 * unknown, once its update count has not changed for this long, in ms.
 * tMotion publishes every 20 ms, so 2 s means it has stopped, not that
 * it is late. At most 5000: the hint keeps only the count's low byte,
 * which at 20 ms wraps every 5.12 s.
 */
#ifndef TERRAIN_HINT_STALE_MS
#define TERRAIN_HINT_STALE_MS 2000u
#endif

#if (TERRAIN_HINT_STALE_MS < 100) || (TERRAIN_HINT_STALE_MS > 5000)
#error "TERRAIN_HINT_STALE_MS must be 100 to 5000"
#endif

/*
 * Bench debugging: the terrain task prints pitch and roll every this
 * many milliseconds once calibrated. 0 turns it off; keep 0 in commits
 * so the shared console stays quiet.
 */
#ifndef TERRAIN_DEBUG_PRINT_MS
#define TERRAIN_DEBUG_PRINT_MS 0
#endif

/*
 * Lift capture: 1 prints every accelerometer sample, ten to a line
 * ("terrain: IMU"), for recording lifts and normal driving to tune the
 * lift detection. Car axes, gains applied, before the calibration bias,
 * in cm/s^2, with the mean wheel speed size. About 2 KB a second over the
 * console mirror; keep 0 in commits.
 */
#ifndef TERRAIN_CAPTURE
#define TERRAIN_CAPTURE 0
#endif

/*
 * Bench tests: 1 adds TER-U06 (record the level reference) and TER-U07
 * (check the axes after mounting) to make TEST=1. They need a person to
 * move the car on cue and take about 40 s. Keep 0 in commits: the whole
 * team's TEST=1 run must not wait for anyone.
 */
#ifndef TERRAIN_TEST_BENCH
#define TERRAIN_TEST_BENCH 0
#endif

/* Public function declarations. */

#endif /* TERRAIN_CONFIG_H */
