SITProjects/INF2004/config/config.h

/*
 *----------------------------------------------------------------------
 *    micro T-Kernel 3.0 BSP
 *
 *    Copyright (C) 2006-2023 by Ken Sakamura.
 *    This software is distributed under the T-License 2.2.
 *----------------------------------------------------------------------
 *
 *    Released by TRON Forum(http://www.tron.org) at 2023/05.
 *
 *----------------------------------------------------------------------
 */

/*
 *	config.h
 *	User Configuration Definition
 */

#ifndef __TK_CONFIG__
#define __TK_CONFIG__

/*---------------------------------------------------------------------- */
/*  Target Name
	Define the system target name. Alternatively, define the target name
	in the development environment.
 */
//#define _IOTE_M367_
//#define _IOTE_RX231_
//#define _IOTE_STM32L4_
//#define _IOTE_RZA2M_

/*---------------------------------------------------------------------- */
/* SYSCONF : micro T-Kernel system configuration
 */

#define	CNF_SYSTEMAREA_TOP	0	/* 0: Use system default address */
#define CNF_SYSTEMAREA_END	0	/* 0: Use system default address */

#define	CNF_MAX_TSKPRI		32	/* Task Max priority */

#define CNF_TIMER_PERIOD	10	/* System timer period */

/* Maximum number of kernel objects (raised for a 5-subsystem team project) */
#define CNF_MAX_TSKID		32	/* Task */
#define CNF_MAX_SEMID		16	/* Semaphore */
#define CNF_MAX_FLGID		16	/* Event flag */
#define CNF_MAX_MBXID		12	/* Mailbox*/
#define CNF_MAX_MTXID		12	/* Mutex */
#define CNF_MAX_MBFID		12	/* Message buffer */
#define CNF_MAX_MPLID		12	/* Memory pool */
#define CNF_MAX_MPFID		12	/* Fixed size memory pool */
#define CNF_MAX_CYCID		12	/* Cyclic handler */
#define CNF_MAX_ALMID		12	/* Alarm handler */

/* Device configuration */
#define CNF_MAX_REGDEV		(8)	/* Max registered device */
#define CNF_MAX_OPNDEV		(16)	/* Max open device */
#define CNF_MAX_REQDEV		(16)	/* Max request device */
#define CNF_DEVT_MBFSZ0		(-1)	/* message buffer size for event notification */
#define CNF_DEVT_MBFSZ1		(-1)	/* message max size for event notification */

/* Version Number */
#define CNF_VER_MAKER		0
#define CNF_VER_PRID		0
#define CNF_VER_PRVER		3
#define CNF_VER_PRNO1		0
#define CNF_VER_PRNO2		0
#define CNF_VER_PRNO3		0
#define CNF_VER_PRNO4		0


/*---------------------------------------------------------------------- */
/* Backwards compatible api support
 *      micro T-Kernel2.0 API support (Rendezvous)
 */
#define USE_LEGACY_API		(0)	/* 1: Valid  0: Invalid */
#define CNF_MAX_PORID		(0)	/* Maximum number of Rendezvous */


/*---------------------------------------------------------------------- */
/* Stack size definition
 */
#define CNF_EXC_STACK_SIZE	(2048)	/* Exception stack size */
/*
 * Temporary stack size, per core.
 *
 * The dispatcher runs on this stack whenever a core has no current task, with
 * interrupts enabled, so an interrupt taken at that moment runs on it too. In
 * the SMP profile that path now includes the global ready-queue assignment,
 * which is far heavier than the single-core reschedule it replaced: a 32-byte
 * exception frame plus the assignment's arrays and call chain does not fit in
 * 256 bytes with any margin. knl_tmp_stack_used() reports the true high-water
 * mark so this number can be set from measurement rather than from hope.
 */
#if CNF_SMP
#define	CNF_TMP_STACK_SIZE	(1024)	/* Temporary stack size */
#else
#define	CNF_TMP_STACK_SIZE	(256)	/* Temporary stack size */
#endif


/*---------------------------------------------------------------------- */
/* System function selection
 *  1: Use function.  0: No use function.
 */
#define USE_NOINIT		(0)	/* Use zero-clear bss section */
#define USE_IMALLOC		(1)	/* Use dynamic memory allocation */
#define USE_SHUTDOWN		(1)	/* Use System shutdown */
#define USE_STATIC_IVT		(0)	/* Use static interrupt vector table */


/*---------------------------------------------------------------------- */
/* Check API parameter
 *   1: Check parameter  0: Do not check parameter
 */
#define CHK_NOSPT		(1)	/* Check unsupported function (E_NOSPT) */
#define CHK_RSATR		(1)	/* Check reservation attribute error (E_RSATR) */
#define CHK_PAR			(1)	/* Check parameter (E_PAR) */
#define CHK_ID			(1)	/* Check object ID range (E_ID) */
#define CHK_OACV		(1)	/* Check Object Access Violation (E_OACV) */
#define CHK_CTX			(1)	/* Check whether task-independent part is running (E_CTX) */
#define CHK_CTX1		(1)	/* Check dispatch disable part */
#define CHK_CTX2		(1)	/* Check task independent part */
#define CHK_SELF		(1)	/* Check if its own task is specified (E_OBJ) */

#define	CHK_TKERNEL_CONST	(1)	/* Check const-type parameter */

/*---------------------------------------------------------------------- */
/* User initialization program (UserInit)
 *
 */
#define	USE_USERINIT		(0)	/*  1: Use UserInit  0: Do not use UserInit */
#define RI_USERINIT		(0)	/* UserInit start address */


/*---------------------------------------------------------------------- */
/* Debugger support function
 *   1: Valid  0: Invalid
 */
#define USE_DBGSPT		(0)	/* Use mT-Kernel/DS */
#define USE_OBJECT_NAME		(0)	/* Use DS object name */

#define OBJECT_NAME_LENGTH	(8)	/* DS Object name length */

/*---------------------------------------------------------------------- */
/* Use T-Monitor Compatible API Library  & Message to terminal.
 *  1: Valid  0: Invalid
 */
#define	USE_TMONITOR		(1)	/* T-Monitor API */
#define USE_SYSTEM_MESSAGE	(1)	/* System Message */
#define USE_EXCEPTION_DBG_MSG	(1)	/* Excepttion debug message */
#define USE_TASK_DBG_MSG	(0)	/* Tsak debug message */

/*---------------------------------------------------------------------- */
/* Use Co-Processor.
 *  1: Valid  0: Invalid
 */
#define	USE_FPU			(0)	/* Use FPU */
#define	USE_DSP			(0)	/* Use DSP */

/*---------------------------------------------------------------------- */
/* Use Physical timer.
 *  1: Valid  0: Invalid
 */
#define USE_PTMR		(0)	/* Use Physical timer */

/*---------------------------------------------------------------------- */
/* Use Sample device driver.
 *  1: Valid  0: Invalid
 */
#define USE_SDEV_DRV		(1)	/* Use Sample device driver */

/*---------------------------------------------------------------------- */
/*
 *	Use function Definition
 */
#include "config_func.h"

#endif /* __TK_CONFIG__ */
