SITProjects/INF2004/app_program/barcode/barcode.c

/**
 * @file barcode.c
 * @brief Barcode subsystem: reads Code 39 with a third IR sensor.
 *
 * tBarcode sets up GP28 and its edge interrupt, then every BARCODE_POLL_MS
 * drains the timestamped edges into a scan (barcode_scan.c). When a quiet
 * zone ends a scan it decodes it (barcode_code39.c), prints the result and
 * publishes it over MQTT in MQTT builds. What the car does with a barcode
 * is not decided yet.
 */

#include "barcode.h"
#include "barcode_code39.h"
#include "barcode_config.h"
#include "barcode_scan.h"
#include "drv_barcode.h"
#include "../communication/remote_command.h"
#include "../line_follow/line_follow.h"
#include "../terrain/terrain_monitor.h"
#if TM_MQTT
#include "../communication/telemetry_queue.h"
#endif

/* Private types, constants, and macros. */
/* Fewer elements than one character is noise, not a failed read. */
#define MIN_REPORT_ELEMENTS BARCODE_CODE39_ELEMENTS
#define US_PER_TENTH_MS 100u
#define CALIBRATION_REPORT_US 500000u
#define SHORT_SCAN_MIN_ELEMENTS 2u

/* Static data. */
ID barcode_tid_read;
static barcode_scan_t scan;
static barcode_trigger_t trigger;
static uint32_t last_edge_us; /* Latest edge, or start of this phase. */

/* Private function declarations. */
static void read_task (INT stacd, void * p_exinf);
static void finish_scan (void);
static void take_edge (barcode_edge_t const * p_edge,
                       line_barcode_phase_t phase);
static line_barcode_phase_t follow_phase (void);
static void trace_widths (void);
#if BARCODE_EDGE_REPORT
static void calibration_report (void);
#endif
static uint32_t now_us (void);
#if TM_MQTT
static void publish (char const * p_text, bool b_reversed);
#endif

/* Public function definitions. */

ER
barcode_init (void)
{
    /* No kernel objects; the task sets up its pin and interrupt. */
    return E_OK;
}

ER
barcode_start (void)
{
    /* Core 0: drv_gpio_irq enables the interrupt in that core's NVIC. */
    barcode_tid_read =
        app_start_task(read_task, BARCODE_PRI_READ, TP_PRC1, "tBarcode");
    return (barcode_tid_read < E_OK) ? barcode_tid_read : E_OK;
}

/* Private function definitions. */
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
