SITProjects/INF2004/(commit log)

2026-09-09 chore(Structure): Included skeletal structure for codebase (#4)
    * skeleton structure
    * Added wokwi diagram with example on how to import functions from modules
    * resolve comments
    [barcode.c, barcode.h, motion.c, motion.h, obstacle.c, obstacle.h]
2026-09-18 Feat(ultrasonic): Initial implementation of obstacle detection (#6)
    * initial implementation of ultrasonic sensor for pico car
    * fix(obstacle): handle echo timeouts and protect interrupt handoff
    * remove test
    * Fix issue of echoes being overwritten and included echo timeout to invalidate measurements
    [obstacle.c, obstacle.h]
2026-09-24 feat(obstacle): Servo to help ultrasonic sensor to scan multiple angles and measure distance (#9)
    * Initial implementation for servo
    * added import for hardware in main
2026-09-25 chore(obstacle): reorganise functions (#14)
    * reorg files
    * rename api from ranging to ultrasonic
2026-09-30 Implement open loop drive (#22)
    * Implement open loop drive
    * Fix brake and coast code
    * Move shared values into shared.h
    * Use actual distance between wheels
    [motion.c, motion.h, motion_config.h]
2026-10-16 feat(imu): add LSM303DLHC driver and terrain calibration (#34)
    * feat(imu): add LSM303DLHC driver and terrain module (phase 1)
    * feat(imu): add start-up calibration and level check (phase 2)
    Calibrate the accelerometer at every start: collect 2 s of still samples, retry on movement, block with NOT_LEVEL if tilted more than 2 degrees from the level reference, then subtract the bias from every reading. Per-axis gains from the six-side test. Re-set up the sensor after repeated read failures, keeping the calibration. Adds terrain_get_calibration, terrain_recalibrate and terrain_calib_text.
    * refactor(imu): rename Pico SDK sources to match their headers
    [terrain.c, terrain.h, terrain_config.h, terrain_platform.c, terrain_platform.h, terrain_process.c, terrain_process.h]
2026-10-16 feat(IR sensor): Add dual IR line sensing and state decisions
    * Add dual IR line sensing and state decisions
    * rename driver and refine line decisions
    * Discard initial IR ADC conversions and document line-follow commands
2026-10-28 feat(obstacle): Minimum-bit data representation for obstacle scanning (#42)
    * included obstacle width measurement
    * fixed obstacle width calculations
    * created obstacle header file to store config
    * robot_type to contain state bits and bytes
    * overhaul structure and update constants usage in obstacle and ultrasonic
    * remove old width calculation
    * include unit test for obstacle
    * resolve feedback
    [drv_ultrasonic.c, drv_ultrasonic.h, obstacle.c, obstacle.h, obstacle_config.h, obstacle_decision.c, obstacle_decision.h, robot_types.h]
2026-10-28 refactor(obstacle): Pack ultrasonic driver flags into one byte (#50)
    pack driver flags into one byte and update existing code
2026-10-28 feat(obstacle): Critical-distance detection, freshness and scan timeouts (#51)
    * obstacle config macros and constants
    * fix macros
    * helper functions to decide based on results
    * include shared flag for critical state
    * fix docs and have stronger typing for robot_types
    * scanner to handle critical bit and detect when object reaches critical distance from obstacle
    * update invalidate_measurement to return no echo if it ultrasonic timesout
    * update doxygen
    * clang formatting
    [drv_ultrasonic.c, drv_ultrasonic.h, obstacle.c, obstacle_config.h, obstacle_decision.c, obstacle_decision.h, robot_types.h]
2026-10-31 feat(obstacle): Calibration of servo and ultrasonic sensor (#54)
    calibration for servo and ultrasonic
2026-11-01 feat(line-following): Implement IR edge readings for line following decisions (#57)
    Use calibrated IR edge readings for line-following decisions
2026-11-01 feat(motion): Count wheel encoders with PIO0 (step 2) (#58)
    * feat(motion): Count wheel encoders with PIO0 (step 2)
    * docs(team): Claim encoder pins and record the PIO split
    * docs(motion): Mark uncalibrated config values with TODO(calibrate)
    * test(motion): Gate motor-driving bench tests behind MOTION_MANUAL_TESTS
2026-11-01 feat(motion): Add odometry, distance moves and stall detection (step 3) (#60)
    [motion.c, motion.h, motion_config.h, motion_drive.h, motion_move.c, motion_move.h]
2026-11-02 feat(motion): Add speed PI loop on each wheel (#64)
    * feat(motion): Add speed PI loop on each wheel
    * fix(motion): Hold the speed loop while its window fills
    [motion_config.h, motion_drive.c, motion_drive.h, motion_move.c, motion_move.h, motion_pid.c, motion_pid.h]
2026-11-02 feat(motion): Add line following and stop-at-line (#69)
    * feat(motion): Add line following and stop-at-line
    * fix(motion): Harden line following per review
    * fix(motion): Use the time since the last line step as the PD dt
    [motion_config.h, motion_move.c, motion_move.h]
2026-11-03 fix(motion): Calibrate encoders and fix test-loop timing (#71)
    * fix(motion): Calibrate encoders and fix test-loop timing
    * fix(motion): Address review comments on encoder calibration
    * test(motion): Check wheels stay still at power-up (MOT-U02)
    [motion.c, motion_config.h]
2026-11-03 fix(motion): Brake distance moves early for the coast after braking (#73)
    * fix(motion): Brake distance moves early for the coast after braking
    * docs(motion): Mark move stop-early as pending ruler check
    [motion_config.h, motion_move.c]
2026-11-04 feat(imu): pitch and roll tilt and calibration settle fix (#52)
    * feat(imu): add pitch and roll with low-pass filter
    Phase 3 of the terrain module.
    - terrain_process: low-pass filter (0.15 s time constant, seeded by the
    first sample), pitch = atan2(y, sqrt(x^2 + z^2)), roll = atan2(x, z),
    and a tilt update with separate pitch and roll filters that can each
    be held.
    - terrain_hint: new single entry point for movement info from other
    subsystems (speed changing, turning, distance). Stub for now: reports
    everything unknown, so nothing is held.
    - terrain_monitor: runs tilt on every calibrated sample; the snapshot
    gains pitch_deg, roll_deg, b_pitch_held and b_roll_held. Tilt resets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
    [terrain.c, terrain_config.h, terrain_fault.c, terrain_fault.h, terrain_hint.c, terrain_hint.h, terrain_monitor.c, terrain_monitor.h]
2026-11-04 feat(obstacle): Measure obstacle width with a 60–120° sweep (#56)
    * remove host test harness
    * add 5-degree settle trials to calibration
    * measure obstacle width with coarse then fine sweep
    * calibrated ultrasonic
    * Modify obstacle calibration to restore 300 mm detection and set edge correction.
    * restore 300 mm detection and set edge correction
    [obstacle.c, obstacle_calibration.c, obstacle_config.h, obstacle_width.c, obstacle_width.h]
2026-11-04 imu hump detection and event queue (#79)
    * imu hump detection and event queue
    * fix(imu): pause hump detection while pitch is held
    [terrain.c, terrain_config.h, terrain_detect.c, terrain_detect.h, terrain_event.c, terrain_event.h, terrain_monitor.c, terrain_monitor.h]
2026-11-04 feat(imu): add hump height (#82)
2026-11-04 feat(motion): Run motion in tMotion with command queue and inhibit (#83)
    * feat(motion): Run motion in tMotion with command queue and inhibit
    * doc(motion): Note which test runs used 10 kHz PWM
2026-11-04 feat(line-following): update line-following motor integration (#78)
    * initial line-following motor command integration
    * Handle transient contention in line-following motor handoff
    * integrate IR line following with motor control and recovery
    * fix: preserve original subsystem initialization order
    [app_main.c, line_follow.c, motion.c, motion.h, motion_command.c, motion_command.h, motion_command_config.h, motion_config.h]
2026-11-04 feat(obstacle): Publish the stop request and result to other tasks (#93)
    * fix(motion): Publish status before raising the motion event
    * feat(obstacle): Export edge offsets and pivot range
    * feat(obstacle): Publish geometry with the scan result
    * feat(obstacle): Add scanner rearm and corridor sweep
    * feat(obstacle): Publish obstacle state and event flag
    * fix(obstacle): Order the obstacle_get_state() copy with barriers
    [motion.c, motion.h, obstacle.c, obstacle.h, obstacle_config.h, obstacle_width.c, obstacle_width.h]
2026-11-04 feat(mission): Bypass manoeuvre (#94)
    * feat(obstacle): Add bypass planner and corridor check
    * feat(obstacle): Add bypass state machine
    * feat(obstacle): Hold motors at start-up and bypass through tMotion
    * docs(team): Add obstacle interfaces IF-06 and IF-07
2026-11-04 feat(obstacle): fix obstacle by ignoring side if same obstacle (#96)
    * fix obstacle by ignoring side if same obstacle
    * watchdog initialization
    [app_main.c, obstacle_decision.c, obstacle_decision.h]
2026-11-04 fix(team): Pin tMotion to core 1 and follow the freeze priority order (#85)
    * fix(team): Pin tMotion to core 1 and follow the freeze priority order
    * docs(team): Describe per-task priorities instead of bands
    [app.h, line_follow.h, motion.c, motion.h, obstacle_config.h, terrain.h]
2026-11-05 feat(obstacle): Enable a geometry-based obstacle bypass (#106)
    Turn the bypass on with the car measured by ruler (width 127 mm, axle to
    pivot 20 mm, rear 162 mm, IR row to axle 60 mm).
    - Turn by an angle toward the gap instead of a fixed 90: as shallow as
    the room in front of the obstacle allows, never below 30 degrees
    (OBSTACLE_AVOID_ANGLE_MIN_DEG); 90 still gives the box. Diagonals,
    the pass and the return are sized from that angle.
    - Plan best effort: a sidestep or pass beyond its limit is capped
    (b_limited) instead of refused, BLOCKED results go round a found edge,
    and PATH_FOUND keeps the scanner's measured direction.
    - OBS-U36..U38 and U46 updated; OBS-U55 added.
    [obstacle.c, obstacle_avoid.c, obstacle_avoid.h, obstacle_config.h]
2026-11-05 feat(obstacle): Preserve measured side clearance when choosing a bypass (#107)
    The side scan already ranks the two ends of the sweep; the planner now
    keeps that evidence instead of choosing by detour length alone.
    - Scanner: publish which ends had free space (the same rule as the side
    decision, obstacle_decision_side_clear()) and the range measured at each
    end, with the obstacle geometry. Log the end readings per sweep.
    - Planner: only sides with free space are candidates, and only if the
    car, shifted aside, passes the point measured at that end (beyond the
    pass, or sidestep + half width + margin out). Free space that is too
    tight on both sides takes the roomier end (b_no_fit), be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
    [obstacle_avoid.c, obstacle_avoid.h, obstacle_decision.c, obstacle_decision.h]
2026-11-05 feat(obstacle): Coordinate scanning, reverse clearance and bounded re… (#108)
    feat(obstacle): Coordinate scanning, reverse clearance and bounded recovery
    - Reverse first when the obstacle is nearer than 200 mm
    (OBSTACLE_AVOID_MIN_ROOM_MM), then sweep the corridor before turning.
    - One sweep at the stop, then drive the whole path
    (OBSTACLE_AVOID_RECHECK 0): side scans stay off during the bypass so
    the sensor keeps watching ahead, and only CRITICAL holds the car.
    - CRITICAL on a move backs off 50 mm (at most twice); still held, it
    re-sweeps the corridor and re-plans from where the car is. With no side
    that fits it reverses 100 mm and sweeps again (300 mm in all), then
    waits held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
    [obstacle.c, obstacle_avoid.c, obstacle_avoid.h, obstacle_config.h]
2026-11-05 feat(motion): Acquire a line already visible when queued motion starts (#109)
    A queued MOVE or TURN with stop-at-line now ends at a fresh, confirmed
    line even when the sensors already see it as the command starts; before,
    it needed the line to disappear and reappear. Stale visibility never
    counts, and the setting lasts one command. motion_move_stop_at_line()
    keeps the edge-only behaviour for other callers.
    - motion_move_acquire_line(), used by run_command() for queued
    stop-at-line commands.
    - Shared: robot_types.h (stop-at-line docs) and TEAM.md (IF-01 note).
    - Host regression testing/motion/host/ (12 checks, ASan/UBSan) and the
    motion TEST_LOG section.
2026-11-05 feat(obstacle): Finish passing the obstacle before reacquiring the route (#110)
    The outward diagonal and the pass never stop at a line, so a line crossed
    on the way out cannot end the bypass early. Once the pass is complete,
    the inward turn and the return both look for a line: a fresh, confirmed
    line ends the detour and FOLLOW hands alignment to the line follower,
    whichever line it is, from the heading the car stopped at. A missed
    return still gets one bounded search, then FAULT with INHIBIT kept; no
    free searching off the route.
    - The overshoot and home-turn legs could no longer be reached and are
    removed, with OBSTACLE_AVOID_LINE_OVERSHOOT_MM and overshoot_mm.
    - Needs #100 (motion acqui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
    [obstacle.c, obstacle_avoid.c, obstacle_avoid.h, obstacle_config.h]
2026-11-05 fix(calibration): Validate sensor and steering calibration (#111)
    Values tuned on the car (2026-11-04) on the circle, figure-8 and U-turn
    tracks, and the obstacle runs.
    - Obstacle: stop at 150 mm instead of 300 mm; servo settle from 120 ms
    per 60 degrees plus a 150 ms margin instead of a fixed 1 s.
    - Line following: right full-black reference 1800 (the right
    sensor reads 1250-2200 over the line edge on the car); search after
    250 ms without an edge instead of 1 s.
    - Motion: full steering 430 and a 128 deg/s cap (the
    2 * speed / track limit at 120 mm/s) for the tightest curves; search at
    80 mm/s and 51 deg/s.
    [motion_command_config.h, motion_config.h, obstacle_config.h]
2026-11-05 fix(motion): Restart line following automatically after a stall (#112)
    * fix(motion): Restart line following automatically after a stall
    The line adapter latched a stall for good, so a short stall (a wheel
    caught on the track edge or a long search) stopped the car until reboot.
    It now clears the latch 500 ms after the stall and lets following and
    searching carry on; a wheel still blocked stalls and latches again. The
    counter restarts whenever the state is not STALLED, so every stall waits
    the full 500 ms.
    For felicia-chuaxy / kaiwenteoo to review: this trades a permanent stop
    for repeated retries against an obstacle that holds a wheel.
    * fix(motion): Bound the stall restart and cover time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
    [motion_command.c]
2026-11-05 chore(obstacle): Clean up diagnostics and retain width-test evidence (#113)
    - Log a scan result only when its flags change: every clear ping
    publishes CLEAR, and printing each one made the USB console drop other
    tasks' lines.
    - Keep the 2026-11-03 width-test console log (2026-11-03_width_c11.txt)
    with the other obstacle logs.
    The temporary line-task diagnostic used while tuning is not part of any
    commit.
    Closes #104
2026-11-05 feat(imu): motion to imu integration stage 1 (#95)
    * feat(imu): motion to imu integration
    * fix(imu): stage 2 of integration, hump detection and height deriving revamp
    - calculate hump height using lean
    [terrain.c, terrain_config.h, terrain_detect.c, terrain_detect.h, terrain_height.c, terrain_height.h, terrain_hint.c, terrain_hint.h]
2026-11-05 feat(imu): add collision detection (#115)
    [terrain.c, terrain_config.h, terrain_detect.c, terrain_detect.h, terrain_hint.c, terrain_hint.h, terrain_monitor.c, terrain_monitor.h]
2026-11-05 feat(imu): add turn rate and turning state (#117)
2026-11-05 feat(motion): Calibration test results S1-S5 (#119)
    * fix(motion): Recalibrate encoder counts per revolution
    * test(motion): Record S01 automatic tests under full load
    * fix(motion): Pace long test traces so the USB console does not drop them
    * fix(motion): Print long traces in bursts and wait for a terminal in MOT-U21
    * test(motion): Record S04 speed-loop calibration run
    * fix(motion): Calibrate feed-forward and top speed from MOT-U19
    * test(motion): Record S04 speed loop results (MOT-U19..U21)
    * test(motion): Record S05 moves; castor flip shortens the 100 mm reverse
    * fix(motion): Raise feed-forward offset for the floor and castor flip (MOT-U09)
    * fix(motion): Brake moves 9 mm ear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
    [motion_config.h]
2026-11-05 test(motion): Record S06 with the calibrated track width (#126)
    * test(motion): Record S00 and S02; U02 watches until the first commanded movement
    * test(motion): Record S06 turn calibration run
    * fix(motion): Calibrate track width from MOT-U11/U12
    * test(motion): Restore the 20 s MOT-U04/U05 hand-turn window
    * test(motion): Record S06 with the calibrated track width
    * fix(terrain): Match track width to motion's calibrated 110.6 mm
    * doc(motion): Close the track width TODO after S06 passed
    [motion_config.h, terrain_config.h]
2026-11-05 test(motion): Record S07 encoder fault timeout (MOT-U17) (#127)
    * fix(motion): Clear a timed-out turn after MOT-U15 so MOT-U16 and U17 can run
    * test(motion): Record S07 encoder fault timeout (MOT-U17)
    * test(motion): Note how the MOT-U17 verdict was read and the local flags
2026-11-05 fix(motion): Tune the straight-line sync loop (MOT-U24..U26) (#129)
    * fix(motion): Define the trace print constants for the sync tests too
    * test(motion): Record S08 calibration run; sync-on drift fails MOT-U25
    * fix(motion): Correct the left curve with a right-wheel scale in the sync loop (MOT-U25)
    * test(motion): Record S08 with the right-wheel scale; MOT-U24 passes
    [motion_config.h, motion_move.c]
2026-11-06 feat(imu): add speed state from wheel speeds (#131)
    * feat(imu): add speed state from wheel speeds
    * fix(imu): wrap long comments and keep the level reference for its own PR
    [terrain.c, terrain_config.h, terrain_detect.c, terrain_detect.h, terrain_monitor.c, terrain_monitor.h]
2026-11-06 feat(imu): add run summary (hump count and heights, collisions, turns) (#135)
    [terrain.c, terrain_monitor.c, terrain_monitor.h, terrain_summary.c, terrain_summary.h]
2026-11-09 feat(integration): Digital line following, barcode turns, bypass and terrain updates (#137)
    Line following is rewritten for the digital IR sensors, with cross junctions,
    U-turns and pivots. A Code 39 reader adds a slow pass over each barcode and
    the turn it asks for. The obstacle bypass plans from the side sweep and
    returns to the line. Terrain counts humps and collisions, and the dashboard
    starts and stops the car and sets the barcode map.
    Closes #136
    [adc_cnf_sysdep.h, app.h, app_main.c, barcode.c, barcode.h, barcode_code39.c, barcode_code39.h, barcode_config.h]
2026-11-09 refactor(integration): Minimum-bit data for everything stored, shared and sent (#139)
    Packs stored, shared and sent data into minimum-bit layouts with clamping helpers in robot_types.h. Telemetry and car status are sent as binary records that the dashboard decodes. Adds the subsystem guide, fixes a missed askew crossing with a turn waiting and a pivot during slow barcode passes, and removes Reverse from the dashboard.
    [barcode.c, barcode_code39.c, barcode_code39.h, barcode_config.h, drv_barcode.c]
2026-11-10 fix(obstacle): Point the scan at the car's true sides (#143)
    Sets OBSTACLE_SERVO_MIRRORED to 0: at 1 an obstacle 30% left and 70% right of the line read with its sides swapped and the car went round its wider side. The bypass watch no longer flips with the setting, since the scan already mirrors every scan angle. OBS-U80 records the car runs: the off-centre obstacle now reads the right way round; one run still went round the long end because the car stood about 10 degrees off square to the face.
    [obstacle_avoid.c, obstacle_config.h]
2026-11-11 feat(imu): Stop the motors when the car is lifted or overturned (#149)
    Collision detection is removed. Terrain checks the mean of the last 100 ms of raw accelerometer samples against the calibration's level reading: an upward part over 1.30 of it is a lift, a tilt over 60 degrees for 300 ms is an overturn. Each adds one to a lift count (IF-11); the obstacle task then stops the car as the dashboard's Stop does, and Start runs it again. The limits come from 100 Hz captures on 2026-11-11 (floor driving at most 1.17, brisk lifts 1.42 to 1.63); a slow, gentle lift is not seen. The status record, run summary and dashboard count lifts instead of collisions. Tests LF01 to LF11 replay cuts of the cap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
    [obstacle.c, robot_types.h, terrain.c, terrain_config.h, terrain_detect.c]
